wZuck/YAKB/firmware/README.zh-CN.md

# YAKB ZMK 固件

本固件同时用于 A0 与 B1.1：GPIO 和矩阵未变，`yakb-a0` 文件名保留 shield / 构建标识。B1.1 只在独立载板装一个 nice!nano，主板 U1 禁装主控；新增模拟滤波后重新校准。

[English](README.md) · [完整复现记录](../docs/reproduce.zh-CN.md)

主控固定为 **nice!nano v2 / nRF52840**。`prebuilt/yakb-a0.uf2` 为键盘版，`prebuilt/yakb-a0-calibrator.uf2` 为 USB CDC 校准版；SHA256 见 `prebuilt/SHA256SUMS`。两者均已编译，尚未上板测试。

使用 `config/west.yml` 固定顶层版本，`west-lock.yml` 冻结全部实际依赖。普通版与校准版共享相同的配列、主控映射、5 行/15 列扫描和 60 个有效位置。矩阵空位 mask 为 `0x0 0x2 0x4002 0x1001 0x6b73`。

## 烧录与校准

1. 断开电池，以 USB 数据线直接连接主控。按 nice!nano 文档进入 UF2 bootloader，复制校准版 UF2。
2. 确认 3.3V、Q1 门极时序和 U4 输出没有异常，再连接出现的 USB CDC 串口；选择常规 115200、8N1。CDC 是 USB 虚拟串口，速率并不决定 EC 扫描速度。
3. 输入 `ec` 并用 Tab 查看设备名，本版节点名为 `kscan0`。若固件输出不同，以自动补全结果为准。
4. 60 键正式机构装好后运行 `ec kscan0 calibration start`。低值采样时不按任何键；提示高值采样后按驱动提示逐个慢按、出现星号后释放，直至完成。
5. 运行 `ec kscan0 calibration export`，保存串口输出作为首件记录；运行 `ec kscan0 calibration save` 明确写入 Flash。
6. 断电重启，核对校准恢复；必要时运行 `ec kscan0 calibration load`。切回正常版 UF2 后再次检查所有键；不要擦除 settings 区来“更新固件”。

少量机构试装用于观察波形、噪声和趋势；完整校准流程需要所有有效位置，不能把未装键的读数当成成品结果。不要在校准过程中让电池或 USB 电源不稳定。

## 默认行为

Fn+1/2/3 选择蓝牙槽位；Fn+4 清除当前槽位配对；Fn+H/J/K/L 为方向键；Fn+Esc 进入 bootloader。默认通过 ZMK 的 USB/BLE 行为工作，细节见 `yakb.keymap`。

D19=P0.02/AIN0 是感应 ADC；D18 不用于 ADC。`power-gpios` 为低有效，控制 Q1，只切断运放供电；MUX 和 nice!nano VCC 在轮询时保留。扫描间隔初始为 4/8/12 ms，需测量实际帧率、漏首击和功耗。深睡眠禁用，当前没有独立可靠唤醒电路。

文件级检查和编译成功不代表 EC 动态范围、RF、功耗或温升已验证。每次修改传感、前端增益或机构预压后重新校准。

## 本版修复与双模切换

编译前必须执行 `scripts/prepare_firmware.py` 应用[经哈希校验的驱动补丁](patches/README.zh-CN.md)。它修复空闲后首键、无效校准端点及零噪声校准的除零问题。合作式优先级参数为 15（实际 -1），开启内核断言。960 组首键逻辑回归及恒定 ADC 的实际校准函数测试通过；不等于上板时延测量。

USB HID 和 BLE HID 均启用。Fn+5 选择 USB，Fn+6 选择蓝牙；Fn+1/2/3 切换蓝牙槽位。首次默认优先 USB，手动选择会保存；同一时刻向所选端点发送按键，不是同时向两台设备广播。连接数据线可作为有线键盘使用，电池断开也可工作；选择 BLE 后可边充电边蓝牙使用，电池开关须打开才能充电。
