wZuck/YAKB/docs/case-design.zh-CN.md

# 外壳改版：降低前沿，收掉方盒感

> **版本范围：A0 基础设计 / 历史记录。** 当前整机为 B1.1；独立主控、直接 USB、专用底壳与 FPC 以 [B1.1 说明](modular/README.zh-CN.md) 和[文件版本表](file-map.zh-CN.md)为准。主板 U1 不装主控。

[English](case-design.md) · [兼容性](compatibility.zh-CN.md)

第一版采用 25.1 mm 等高平底壳，容积和净空简单，但侧面过直、前沿偏厚。当前主方案已改为 **R8 大圆角、下裙内收、浅楔形底面**。这是实际 CAD 修改，不只是换渲染颜色。

新版外壳与键帽包络

| 项目 | 第一版 | 当前版 |
| --- | --- | --- |
| 平面外包络 | 301×110.6 mm | 299×108.6 mm |
| 标称壳体前高，不含脚垫/键帽 | 25.1 mm | 21.4 mm，减少 3.7 mm / 约 15% |
| 标称后高 | 25.1 mm | 25.1 mm |
| 底面 | 平底 | 约 1.95°，贴桌后形成低倾角 |
| 顶部平面圆角 | R5 | R8 |
| 侧面 | 等宽直墙 | 下裙约内收 1.0 mm，多段斜面过渡 |
| 上框边缘 | 直角 | 0.7 mm 圆边 |
| 电池 | 水平、深腔 | 与内底面平行，重新检查包络 |
| 定位板外缘 | 裸露层间空隙 | 0.3 mm 边缘间隙的台阶口袋，上缘封住空隙 |

CAD 侧面

尺寸均以 PCB 顶面 z=0 定义；本页包络与旧报告数值沿用构造坐标，交付 CAD 的 Y 为其负值。前/后高是壳体顶面到延伸底面平面的标称高度；实际圆角和下裙会收去下缘材料。底板厚度 2.4 mm，前端底面 z=-10.8，后端 z=-14.5。主控仍在前右下方，因此保留约 0.5 mm 级别的模型净空；继续削薄需改变主控安装、插座高度或内部布局，不能只削外壁。

电池仍是完整包络 ≤60×35×5.5 mm 的带保护 1S 软包；它沿内底面倾斜，并不要求弯折电池。当前旋转后的轴向包络约 x=114…174、y=5.417…40.584、z=-11.144…-4.456。试装时使用与该厚度相符的固定材料，避免电芯或保护板受压。

## 实际参考了哪些开源壳

- [Bakeneko 60 V3](https://github.com/kkatano/bakeneko-60)：参考低前沿、明确侧面比例和倾角。上游标称前高 18.5 mm、6°、外包络 295×110×30 mm。它没有本项目的前部插座主控、电池和 NiZ 叠层约束，数值不能直接套用；本版也没有宣称采用其 O-ring 安装结构。
- [PH60](https://github.com/ph-design/PH60)：参考可打印外壳、独立电池空间、可拆装上盖思路；已查阅本地 HHKB 6u STEP。没有直接复制上游网格或磁吸结构。上游分体打印解决消费级打印床限制；本版当前仍为一体件，需要约 320 mm 级平台或服务。
- [HSKB](https://github.com/hungrygeek/HSKB) / 原始 Dev01-D 版本：参考真实 6u HHKB 底行与两侧挡块的比例；不能把 MX 一体定位板直接替代 NiZ 1.6 mm 定位板。
- [ECneko60](https://github.com/mattyintegrals/ecneko60)：真实 NiZ + EC60 + 开源 Bakeneko 的装配记录，用来核对“开源 60% 壳可作为 EC 改造基础”，同时确认需要修改机构，不能当作通用即插即用证明。

这些项目是结构和比例参考，当前壳体仍由 YAKB 参数化源独立生成。来源与许可边界见 [sources.md](sources.md)。

## 文件与打印

- `mechanical/case_base.step`、`case_bezel.step` 和 `assembly.step` 保留统一装配坐标。
- `mechanical/case_base.stl` 特意旋转到底面平放 z=0，适合切片；因此不要用这个打印 STL 与 PCB 坐标直接对齐。上框 STL 可由切片器平放。
- 先用同工艺测试圆角边缘、M2 热熔螺母、NiZ 和稳定器试片，再打印整套。
- 所选电池、主控、USB 插头与壳体的交集和最小间距见 `reports/mechanical.json`；真实线缆、螺丝和轴体仍须首件验证。

隐藏螺丝更新：上框正面完全封闭，8 颗螺丝由底面锁入上框盲孔螺母柱。新增定位板螺母柱避让与天线开窗；沉孔所需壁厚将下裙内收限制为 1.0 mm。实际 16 组装配交集见机械报告，螺丝长度和热熔螺母见[焊接指南](soldering-guide.zh-CN.md)。
