wZuck/YAKB/reports/drill-report.txt

Drill report for YAKB.kicad_pcb
Created on 2026-10-22T16:17:43

Copper Layer Stackup:
    =============================================================
    L1 :  F.Cu                      front
    L2 :  In1.Cu                    in1
    L3 :  In2.Cu                    in2
    L4 :  B.Cu                      back

Drill file 'YAKB-PTH.drl' contains
    plated through holes:
    =============================================================
    T1  0.250mm  0.0098"  (2 holes))
    T2  0.300mm  0.0118"  (243 holes))
    T3  0.750mm  0.0295"  (2 holes))
    T4  1.000mm  0.0394"  (4 holes))
    T5  1.092mm  0.0430"  (24 holes))

    Total plated holes count 275

Drill file 'YAKB-NPTH.drl' contains
    unplated through holes:
    =============================================================
    T1  2.499mm  0.0984"  (2 holes)  (with 2 slots)
    T2  2.499mm  0.0984"  (1 hole)

    Total unplated holes count 3
