wZuck/YAKB/docs/compatibility.zh-CN.md

# YAKB A0 兼容性与采购边界

> **B1.1 更新：** 以下内容描述 A0 基础板。独立主控、直接 USB、新底壳、FPC 和焊接差异以 [B1 说明](modular/README.zh-CN.md) 为准；B1 主板 U1 不再安装主控。

[English](compatibility.md) · [设计尺寸](design.zh-CN.md) · [装配指南](soldering-guide.zh-CN.md)

以 **GH60 / Poker 托盘外形和 Lot60 实际孔槽坐标**为默认接口，另提供完整自有打印壳。尚未指定或试装任何商用外壳，以下“目标”不代表已经实物兼容。

| 对象 | 结论与条件 |
| --- | --- |
| 自有 YAKB 底壳 + 上框 + plate_case | 共同参数生成，包络检查通过；NiZ 卡扣、胶碗预压、卫星轴和线材须首件验证 |
| GH60 / Poker 类托盘壳 | PCB 外形 285×94.6、安装孔槽参考 Lot60；逐个核对支柱、螺丝头、底部元件、电池净高和 USB，不能只看“60%” |
| Tofu 类金属壳及其他铝壳 | 未验证具体代际；须有天线非金属窗口、合适安装方式、电池空间。全封闭金属腔不作为默认 BLE 方案 |
| PH60 HHKB 6u 打印壳 | 可改造候选；上游定位板约 284.75×107.25×5 mm，与本版 1.6 mm NiZ 板不同，不能直接套用 |
| MX 60% 原配定位板 | 不直接适用；HHKB 底行、6u 空格和 NiZ 卡扣均需专用开孔 |
| 原装 HHKB/Topre 键帽 | 本版选 MX 十字 NiZ 滑块，不承诺兼容 Topre 键帽 |
| 普通 6.25u / 偏心轴 6u 空格 | 不适用；需要中心十字 6u，稳定器中心距 95.25 mm |
| NiZ 整张 60% 胶碗 | 必须逐键对照；优先分体碗或适配此 HHKB 布局的胶碗片 |
| 普通机械轴 ZMK 扫描固件 | 不适用；必须使用本项目 EC 驱动配置和逐键校准 |

## 统一坐标和安装接口

PCB 后左框角为 (0,0)，x 向右、y 向使用者；PCB 顶面 z=0。所有数值单位 mm。孔槽中心由 Lot60 板边基准平移得到，而非重新假定为整数网格。

| 孔槽 | X | Y | 外包络宽×高 |
| --- | ---: | ---: | --- |
| 左开口槽 | 1.4579 | 56.5010 | 7.00024×2.49936 |
| 左上圆孔 | 25.1983 | 27.9006 | Ø2.4994 |
| 中央长孔 | 128.1990 | 46.9998 | 5.00126×2.49936 |
| 左下矩形避让 | 93.0991 | 82.5500 | 7.6×15.1 |
| 下方长孔 | 190.4984 | 85.2005 | 5.00126×2.49936 |
| 右开口槽 | 283.5402 | 56.5010 | 7.00024×2.49936 |

槽只是 PCB 的避让轮廓。轴壳、胶碗、垫片和螺丝头的外径可能比槽宽大，仍须从实物或供应商模型检查。特别注意中央槽附近以及长键下方，禁止靠拧弯 PCB 强行装配。

## 外壳验配顺序

1. 导入 `pcb_envelope.step` 与目标壳体，统一坐标，检查全部支柱和孔槽；用 1:1 纸样复核。
2. 叠加轴壳、胶碗和定位板实际尺寸，确认 6 mm 初始板间净距能形成正确预压；螺丝头不能挤占机构。
3. 核对 PCB 下方最低主控约 z=-8.1，以及电池包络 z=-11.144…-4.456。电池完整包络包含保护板、包膜和导线。
4. 检查 USB 数据延长组件在后左 x=18.6465、z=-5 的开口；主控 USB 朝左，需要真实插头和弯线空间。
5. 为定位板设计可靠承托。`plate_tray.dxf` 只有托盘外形和键孔，未为所有第三方壳定义固定结构。
6. 检查天线区域 x=268…285、y=79…91 的金属避让，以及紧邻壳壁时的蓝牙表现。
7. 安装前确认开关、电池和复位线可达；不压电池、走线不跨热熔铜螺母。

## 自有壳加工

一体底壳尺寸 299×108.6 mm，适合 320 mm 级平台或打印服务；不能默认放入 256 mm 打印平台。优先 PETG/ABS/ASA，结合机器实际收缩率校准，先打印开孔和热熔螺母试片。保留原始 STEP，若分段打印，接缝、定位销及强度需要另外设计，现有 STL 未声明支持任意切片拼接。

自有壳定位板 295×104.6×1.6 mm，8 处边缘缺口避让上框螺母柱，右下有天线窗。上框改为底部锁入盲孔螺母，正面无孔；M2×20/18/16 分别用于后排/两侧/前排。孔径、螺母和螺钉头要求见[焊接指南](soldering-guide.zh-CN.md)。PCB支柱仍用Ø3.3×4.5 mm螺母孔。
