wZuck/YAKB/docs/consistency-review.zh-CN.md

# 全仓库一致性复核

[English](consistency-review.md) · [文件版本表](file-map.zh-CN.md) · [机器检查记录](../reports/repository-consistency.json)

复核日期：2026-10-23。当前整机为 B1.1；共享 A0 主板、定位板和上框。本次没有改铜、引脚或外壳几何，重点修正同一仓库内不同版本、操作说明、计算和交付表之间的矛盾。

| 发现 | 修正 |
| --- | --- |
| 根 README 推荐 B1.1，却仍把 A0 的 299×108.6 mm 壳体、40 个板位和 A0 下载入口当主体 | 中英文首页统一为 B1.1：299×136.6 mm 最大包络、46 个实装板位 / 接线位置加一条 FPC，使用配套底壳 / 舱盖入口 |
| 多份旧文档缺少范围提示，USB 延长与直接 USB 两种结构并列出现 | 为 A0 记录加版本范围；新增逐目录 / 文件版本表，明确共享件、当前件与历史件 |
| 设计说明称 CAD 不转换 Y，和已修正的交付文件相反 | 统一为 PCB / JSON 构造 y 向使用者，交付 CAD Y=-y；打印 STL 另有落床旋转 |
| 外壳前高同时为 21.0 和 21.4 mm，电池净距仍写 0.75 mm | 按参数和报告统一主体前高 21.4 mm、后高 25.1 mm，电池至底壳最小净距约 0.526 mm |
| “扫描总电流”又额外叠加一次背景电流 | 改为扫描 / 等待分别加权；同步基础与模块功耗报告、设计说明及多电池表。基础 1000mAh 混合情景约 12.8 天；B1 连续活动约 202–203 小时，均未实测 |
| B1 继承 A0 表，主板 U1 禁装项仍属实装，FPC 漏列 | U1 为独立 DNP，增加 FPC 线缆项；合并电子 BOM 与检查表同步，46 实装板位 + 1 FPC + 1 DNP + 60 电极，共 108 记录 |
| 小板插座坐标取焊盘平均值，封装统一写成泛称 | 改取保存 PCB 的原生封装原点、值与封装名；JMAIN 原点 (0,0)，引脚组中心 (20,9.5)，明确区分 |
| 基础 CSV 将所有非电极标成通孔；电池开关备注混入常开按钮 | 按实际贴片 / 通孔标面别，SW1 为保持式 SPST，SW2 为常开瞬时复位 |
| B1 共用图上仍印 A0 的 18 步编号；顶 / 底视图说明笼统 | 从同一原生主板数据另生成 B1 的 21 步编号图，小板顶视 / 主板镜像背视说明分开；线缆坐标显示“—” |
| 多电芯指南限制整个包为单电芯尺寸，并写成只允许 1S2P / 1S3P | 单芯仍可用带保护 1S；多芯分别核对各仓与共享保护板，仍只允许厂家配组单输出包 |
| 少量机构试装被写成可直接运行完整 60 键校准 | 少量试装先测波形；预编译完整校准须装齐 60 键，少键校准需要匹配测试固件 |
| 模块 ERC 检查只读顶层，漏看 `sheets[].violations` | 修正两处检查器；新增注入 ERC 子页、DRC、未连线与一致性错误的拒绝检查。当前保存及重新运行的原生报告均为零错误 |
| 小板逐焊盘 CSV 保留未布线时的空 NC 名称 | 从已保存 PCB 重新提取四张模块板的 CSV，并纳入输出哈希检查 |

检查包括：全部 Git 管理及本次新增交付文件的 SHA256 清单；JSON / CSV / Python 解析、ZIP CRC、PNG 解码、GLB / UF2 / STL / STEP / PDF 格式完整性、XML 与 DXF 解析；文档 / HTML 本地链接；逐项 BOM / 指南 / 原生封装坐标；FPC 24 路；主板及四张模块板原生 ERC/DRC；既有机械、渲染、加工 ZIP、固件哈希验证。机器报告逐文件列出实际执行的检查，不把格式检查写成全部工程性质证明。

复核命令：先用 KiCad Python 运行 `verify_modular.py` 刷新原生提取，再用项目 Python 运行 `verify_release.py`、`verify_modular_release.py`、`verify_repository.py --native`。内容修改后按[复现文档](reproduce.zh-CN.md)刷新对应产物，不能只重写哈希来消除过期提示。

未完成项仍是实物试验：NiZ / 稳定器配合、FPC 接触与锁止、USB 真实高度及插拔受力、扫描 / 充电噪声、蓝牙干扰、温升与续航。浏览器安全策略未允许本次打开本地指南页面，故未声称完成浏览器交互验收；已检查交付 HTML / JS、链接、数据和生成图片。
