wZuck/YAKB/docs/electrical-analysis.zh-CN.md

# YAKB 电气、干扰与功耗分析

> **B1.1 更新：** 以下内容描述 A0 基础板。独立主控、直接 USB、新底壳、FPC 和焊接差异以 [B1 说明](modular/README.zh-CN.md) 为准；B1 主板 U1 不再安装主控。

[English](electrical-analysis.md) · [计算数据](../reports/electrical-analysis.json) · [多电池研究](battery-options.zh-CN.md)

结论：支持 USB HID 和 BLE HID；已修复可确定的连接、封装和固件问题，但本版还没有实板噪声、射频或电流测量，不能把 ERC/DRC 通过当成抗干扰认证。下面明确区分原生文件测量、器件资料和计算假设。

## 双模连接

正常版与校准版实际构建均启用 `CONFIG_ZMK_USB=y`、`CONFIG_ZMK_BLE=y`。Fn+5 选择 USB，Fn+6 选择 BLE；Fn+1/2/3 选择蓝牙槽位。USB 初始优先，手动选择会保存；一次只向选中的端点发按键。接数据线可无电池使用，选择 BLE 后可以用 USB 供电并蓝牙输入。电池开关断开时不能充电。[ZMK 输出行为](https://zmk.dev/docs/keymaps/behaviors/outputs)

USB D+/D−留在成品主控与完整 USB 2.0 数据延长组件中，没有穿过主 PCB 的传感布线。线缆必须支持数据、保留屏蔽和可靠接头；不要改成仅充电线或自行拼裸线。nice!nano 原厂充电功能和电源路径见[官方文档](https://nicekeyboards.com/docs/nice-nano/)。

## 模拟信号与串扰

| 项目 | 本版证据 / 分析 | 处理与剩余验证 |
| --- | --- | --- |
| MUX 料号 | 原 `SN74HC4051D` 与引用的 TI 型号不对应；改成有效 SOIC-16 订货号 `CD74HC4051M96`，管脚和焊盘不变 | 采购 HC CMOS 版，不能随意换成 HCT 或 CD4051B；[TI 料号](https://www.ti.com/product/CD74HC4051/part-details/CD74HC4051M96)、[数据手册](https://www.ti.com/lit/ds/symlink/cd74hc4051.pdf) |
| 高阻 SENSE | 实际走线总长 **162.105 mm**；包括分支，不是端到端距离 | 这是当前主要模拟风险。寄生电容会压低信号，长线可能接收数字边沿与 RF；尚未做场求解或实板采样 |
| ADC / FB | ADC 总线长 **58.656 mm**，FB **21.034 mm**；ADC 被低阻运放驱动，FB 仍敏感 | 检查过冲、振铃、稳定性和射频整流；若不足，优先把两个 MUX、反馈和 C4 集中布置后重新布线，不能仅靠改软件阈值 |
| 放大与采样 | 非反相增益 101；SAADC 12 bit、内部0.6 V参考、1/6增益，名义量程3.6 V，1 LSB约0.879 mV，折算输入约8.70 µV | 这不是有效精度。3.3 V运放的输出摆幅、噪声与实际压下差值才决定裕量 |
| 放电与建立 | 每点10 µs放电、5 µs预采样，SAADC采集10 µs；每帧运放预热200 µs | R32×C4=1k×220pF，单独时间常数0.22 µs；总电容还包含两路MUX、走线与电极，不能用这个单值认证10 µs已足够 |
| 行列串扰 | 100Ω行串阻缓和边沿；仅选择一路MUX；未用通道接地；内层避让感应区 | 仍须测相邻键、多键和快速切换时的残留电荷；禁止随意给电极区加地平面或覆锡 |
| 电源 / 回流 | 各IC有去耦，Q1只切运放电源；MUX与VCC保留；没有连续地平面 | 地线总长约2458 mm是整网所有分支之和，不能当成单根回路线或阻抗。稀疏回流可能引入充电/数字地噪声，需示波器验证 |

OPA350 的 38 MHz 带宽不能保证这套长线布局稳定；数据手册给出的典型静态电流约5.2 mA、25°C最大7.5 mA。将它断电再开启也需要在实际负载下验证建立时间。[TI OPA350 数据手册](https://www.ti.com/lit/ds/symlink/opa350.pdf)

驱动读数期间有短临界区；它不等于已与 BLE 无线时隙协调。固件逻辑回归不模拟 SAADC 中断或无线抢占，应在持续蓝牙通信下测完整帧耗时、首键与释放事件。零噪声校准、无效端点和优先级问题已修复，见[修复记录](review-fixes.zh-CN.md)。

## 蓝牙与外部干扰

U1 天线朝PCB右侧，全铜层避让范围为 x=268…285、y=79…91 mm。原定位板在其正上方是实体，若用金属会构成潜在遮挡；现已在右 HHKB 挡块下开 **21×16 mm** 窗，实际 STEP 与该投影的交集为零。优先无铜 FR4/G10 定位板和塑料外壳；即使选金属板，也必须保留开窗。

开窗仅移除了直接上方金属，不能认证射频性能。金属壳、USB屏蔽线、电池铝塑膜、铜螺母和手部仍会改变天线环境；线缆不得穿过该区。多电芯版本将电芯放在后部，须重新测EC基线和蓝牙。不能将几何距离换算成保证的无线距离。

2.4 GHz Wi-Fi、USB3设备和拥挤无线环境可能造成丢包/重传；BLE重传又会提高电流。塑料壳也不能保证不受影响。用固定接收端对比裸板、闭壳、USB延长线安装、多电芯安装四种状态，在1/3/5 m和常用桌面位置记录RSSI、断连、按键丢失与释放；同时运行附近Wi-Fi流量。RSSI仅辅助定位，最终以输入可靠性为准。

## 可复算功耗预算

**这些是未测量的情景估算，不是上下限保证。** 每帧60个有效位置，单是预热和忙等待就有 `0.2 + 60×(0.010+0.005) = 1.1 ms`，采集窗口再加0.6 ms，还没有计入转换、GPIO、MUX、调度和无线争用。因此不能把4/8/12 ms等待值直接当整帧周期。

采用帧耗时2/3/6 ms、扫描时总电流8.2/8.7/13.5 mA、背景0.1/0.25/0.6 mA三个情景。扫描电流包括运放和主控；背景包含保留供电、蓝牙平均开销与板级消耗。主控实际电流随CPU/RF状态变化，器件峰值不能替代整机平均值。[Nordic 电流说明](https://docs.nordicsemi.com/r/bundle/ps_nrf52840/page/chapters/current_consumption/doc/frontpage.html)

以电池侧电流作一阶预算，暂按VCC输入/输出电流近似相等；实际稳压效率、温度和负载必须测。另计每帧100nF电容完全充电的保守开销：

扫描阶段总电流已包含背景负载；背景电流仅按等待时长加权，避免重复计入。

`Iavg = (Ibackground × twait + Iscan_total × tframe + 0.1µF × 3.3V)/(tframe+twait)`

| 状态 | 等待 | 情景电流范围 | 中间估计 | 1000mAh、80%可用的中间续航 |
| --- | --- | --- | --- | --- |
| 活动 | 4 ms | 2.85–8.37 mA | 3.92 mA | 204小时，约8.5天 |
| 空闲 | 8 ms | 1.75–6.15 mA | 2.58 mA | 310小时，约12.9天 |
| 长空闲 | 12 ms | 1.28–4.92 mA | 1.96 mA | 408小时，约17.0天 |

每天8小时活动、16小时长空闲，中间估计约 **12.8天/1000mAh**。500mAh约减半；2000/3000mAh在电流不变时约翻倍/三倍。当前无独立唤醒电路，深睡关闭，因此不承诺几个月待机。实际帧若超过6 ms或RF重试频繁，电流可能超出表中范围。

默认约100mA充电，1000/2000/3000mAh的理想恒流下限分别10/20/30小时，实际还有恒压尾段和使用负载。不要为缩短时间直接桥接BOOST；提高电流需核对电芯、保护板、线缆和主控温升。[nice!nano FAQ](https://nicekeyboards.com/docs/nice-nano/faq/)

## 首板验收记录

1. USB直连、USB延长、USB充电+BLE、纯电池BLE分别记录VCC/AFE电源纹波、SENSE/ADC波形及每键空载/按下统计；探头本身会增加电容。
2. 至少记录每键1000帧空载/按下分布；首件目标为两分布可清晰分离、相邻键切换无误触。可用“压下差值≥10×噪声峰峰值”作为初始工程门槛，并检查整个温度/电量范围；这不是器件保证。
3. 测第一帧上电建立、最远电极、连续多键、缓慢回弹、空闲首击和BLE重传负载。若出现振铃/电源耦合，先改布局、回流或采样时序再重校准。
4. 在电池端记录活动/空闲/长空闲/重连/关机平均电流及峰值，用实测值替换报告中的假设。记录满电充电与多电芯包的温升；开关断开还要计电芯保护板自耗。

EC 现在使用 SAADC 逻辑通道1，物理输入仍为 AIN0/P0.02；逻辑0保留给 ZMK 电池驱动的 VDDHDIV5。原先两者共用逻辑0会覆盖通道设置，已分离并增加两种初始化顺序的回归检查。
