wZuck/YAKB/docs/modular/interface-review.zh-CN.md

# B1.1 接口修正与小样验证

[English](interface-review.md) · [尺寸合同](../../design/fpc-interface.json) · [整机说明](README.zh-CN.md)

复核使用 Molex 编制的 `2005281000-SD` 修订 C，2019-08-14 发布，PDF 第 5 页料号表含 **2005280240**，第 6 页是端部配合尺寸。[厂家图镜像](https://www.micro-processor.com/parts-file/c2-2005280050.pdf)。来源地址、文件 SHA256 和页码已记录；原图不随仓库重新分发。这是可追溯的图纸依据，不能据此声称采购批次已验收。

| 项目 | B1 旧文件 | B1.1 当前文件 |
| --- | --- | --- |
| 端部外宽 | 24 mm | 25 mm，带定位耳 |
| 露铜指 | 0.6 × 4 mm，前缘退缩 | 0.7 × 3.5 mm，延伸到插入边缘 |
| 定位/锁止 | 无定位耳 | 两侧定位耳及圆角，细节见尺寸合同 |
| 覆盖膜 | 每根铜指独立小开窗 | 每端一片连续开窗 |
| 补强 | 仅文字假设，没有实体厚度 | 非接触面 5 mm 补强，CAD 端部总厚 0.30 mm |
| USB 插头包络 | 8 × 5.5 mm | 12 × 8 mm 设计验收包络；开口 14 × 10 mm |
| USB 壳孔 | 仅底壳切孔 | 底壳和盖板共同切孔，剩余盖板屋顶 1.85 mm |

厂家图同时给出了有耳和无耳端部。本次选用带耳形式；“原来没有耳”本身不构成不合规，旧版确定的尺寸错误是外宽和铜指几何。

原先的“DRC 0”只验证了旧文件的连接和规则，没有证明它符合连接器配合图。B1.1 仍检查所有铜线间距；只有插入边缘铜指采用明确的负板边间距规则来允许贴边，且每个端部 footprint 允许其内部覆盖膜开窗合并。这两项是端子结构要求，刚性板和其他铜线的规则保持有效。端部名义尺寸、两端 4 mm 插入基准、线序及连续窗口另作检查。

短 FPC 另附 [含端部补强的机械包络 STEP](../../mechanical/modular/fpc_mating_coupon_envelope.step)；同名 `-native.step` 是 KiCad 均匀板厚输出，不能用它判断补强厚度。程序另检查试件确实来自当前底壳、整条软板没有越出外壳包络，四个交付打印 STL 的最低点均落床，见[试件文件检查](../../reports/modular/sample-checks.json)。

## 先加工两种试件

1. [短 FPC 试片加工 ZIP](../../fabrication/modular/YAKB-FPC-coupon-B1.zip)：两个插入端相距 25 mm，端部与整条软板共用同一生成函数和尺寸合同。只用于台架配合/导通验证，不装入整机，不是可替代长软板的通用 FFC。向软板厂提交同包 `FLEX-STACKUP.json`；覆盖膜、补强、表面处理必须一起报价。
2. [后舱底壳试件 STL](../../mechanical/modular/rear_pod_fit_coupon.stl)：从当前整机底壳直接裁取，包含 USB 开口、载板支柱、承压座和卡唇。配合 [同一后舱盖 STL](../../mechanical/modular/pod_lid_B1.stl) 使用。它保留真实斜底，已放到打印床平面，前侧为裁切开口。

实际后舱试件

[下载双语实测记录表 CSV](qualification-checklist.csv)。所有条目保持“待测”，没有填写虚构的验收结果。

## 记录后再决定整机加工

| 核对项 | 图纸或设计基准 | 实测记录 |
| --- | --- | --- |
| 采购料号与批次 | Molex 200528-0240；不凭外形替代 | 待填 |
| 端部厚度 | 0.30 ± 0.05 mm，包含补强与胶层 | 待填 |
| 插入与锁止 | 4 mm 名义插深；两端闭合后不翘起、无异常阻力 | 待填 |
| 导通 | 断电测 A1→B24 至 A24→B1，并排除相邻短路 | 待填 |
| 主控安装高度 | 以实际焊接/插座组件测 PCB 顶面到 USB 口中心 | 待填 |
| USB 凹入与插头 | 测真实插口面相对壳外壁的位置、插头塑料尺寸及完全插入状态 | 待填 |
| 板边卡唇 | 1 mm 载板，0.30 mm 名义竖向间隙；不压元件 | 待填 |
| 受力 | 插拔时 PCB 不明显弯曲、不松动，端口焊点不承担壳体错位 | 待填 |
| ADC 与充电 | 纯 USB、纯电池、充电+BLE 三种状态记录噪声和电流 | 待填 |

USB 的 12 × 8 mm 数值是本设计要求使用的插头外壳包络，不是对所有 USB-C 线缆的尺寸承诺。nice!nano 官方给出的模块总厚度为 3.2 mm，但未把它当作“USB 口中心高度”；现有 6.5 mm 模块及安装包络也不是厂商精确模型。[nice!nano 官方规格](https://nicekeyboards.com/nice-nano/)

目前完成的是图纸与文件复核、原生电气规则和选定实体净空检查。表内实测项没有填写，不能将本次修订称作实物已通过。
