wZuck/YAKB/design/pin-map.csv

Signal | Pro_Micro_D | nRF52840_pin | U1_pad
ROW_DRV0 | 0 | P0.08 | 2
ROW_DRV1 | 1 | P0.06 | 1
ROW_DRV2 | 2 | P0.17 | 5
ROW_DRV3 | 3 | P0.20 | 6
ROW_DRV4 | 4 | P0.22 | 7
MUX_A | 5 | P0.24 | 8
MUX_B | 6 | P1.00 | 9
MUX_C | 7 | P0.11 | 10
MUX0_INH | 8 | P1.04 | 11
MUX1_INH | 9 | P1.06 | 12
DRAIN | 10 | P0.09 | 13
AFE_ON_N | 15 | P1.13 | 16
ADC | 19 | P0.02/AIN0 | 18
