wZuck/YAKB/assets/modular/B1-controller-plan.png

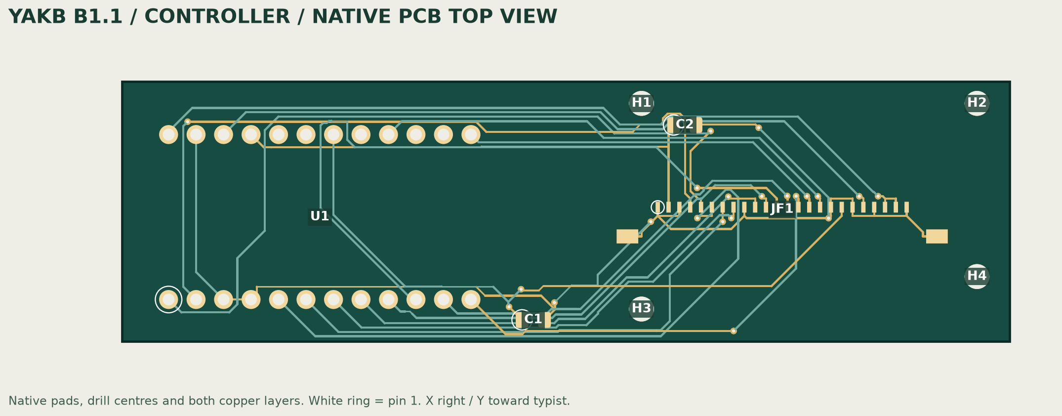
assets/modular/B1-controller-plan.png
