wZuck/YAKB/assets/modular/B1-FPC-coupon-plan.png

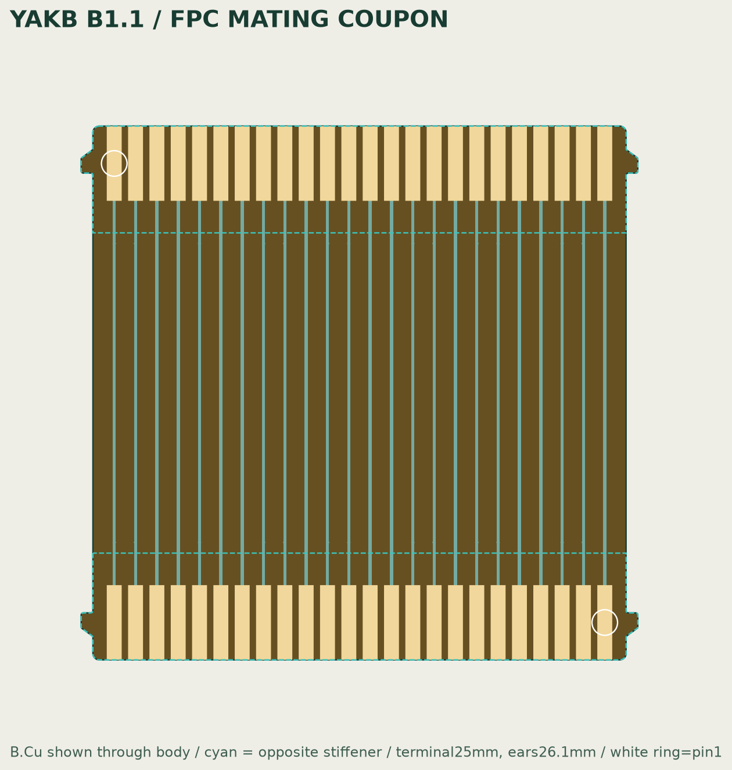
assets/modular/B1-FPC-coupon-plan.png
