wZuck/YAKB/assets/modular/B1-interposer-plan.png

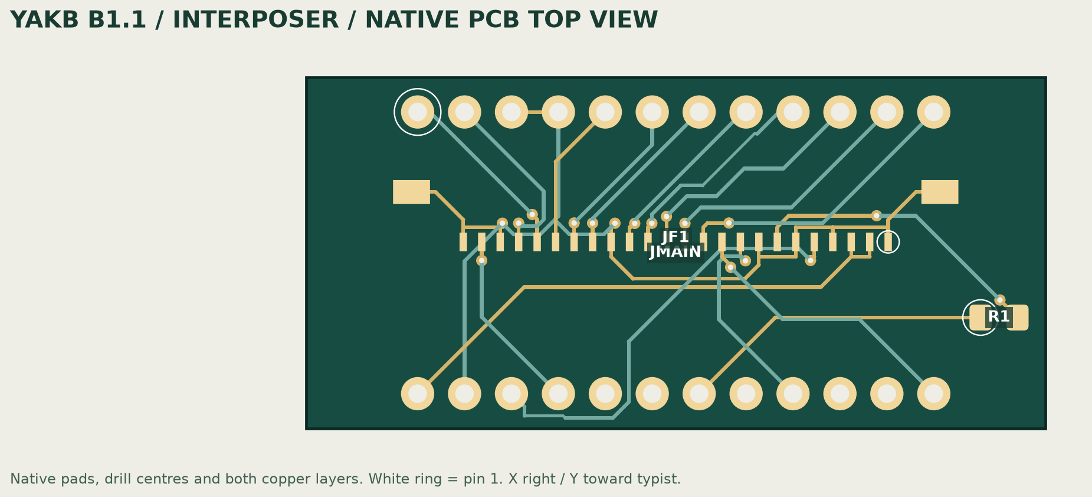
assets/modular/B1-interposer-plan.png
