wZuck/YAKB/assets/modular/B1-shaped-FPC-plan.png

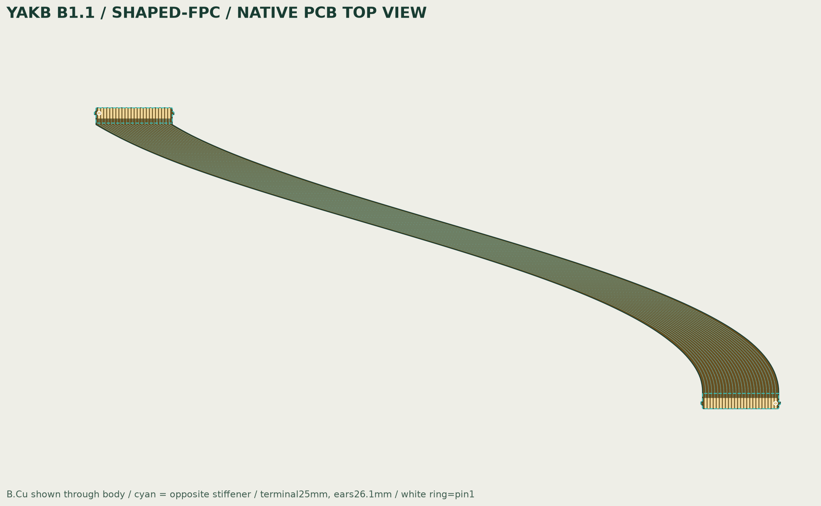
assets/modular/B1-shaped-FPC-plan.png
