wZuck/YAKB/assets/modular/B1-top.png

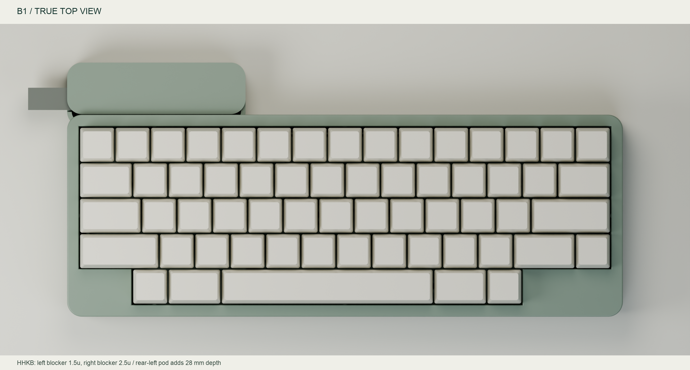
assets/modular/B1-top.png
