wZuck/YAKB/assets/pcb-bottom.png

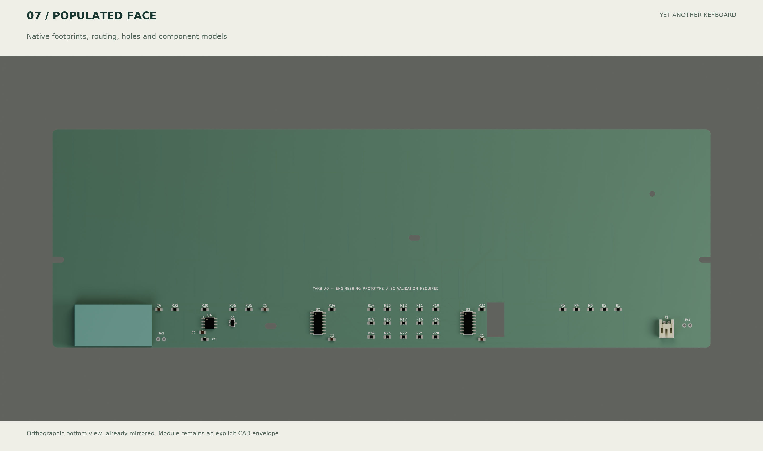
assets/pcb-bottom.png
