wZuck/YAKB/assets/pcb-top.png

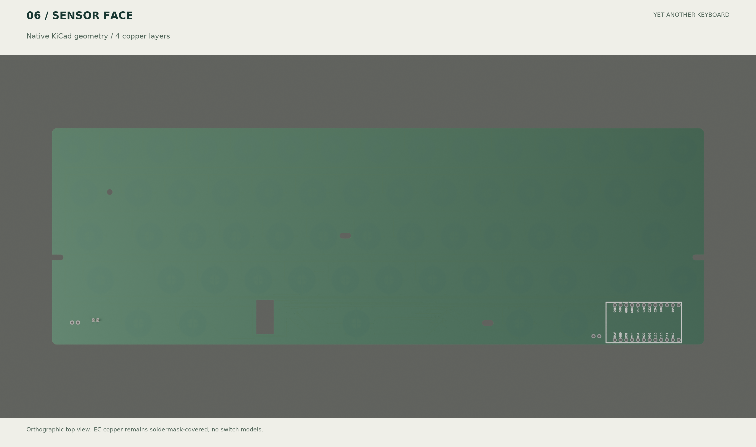
assets/pcb-top.png
