wZuck/YAKB/docs/inventory-review.zh-CN.md

# 库存对照与采购建议

> **版本范围：A0 基础设计 / 历史记录。** 当前整机为 B1.1；独立主控、直接 USB、专用底壳与 FPC 以 [B1.1 说明](modular/README.zh-CN.md) 和[文件版本表](file-map.zh-CN.md)为准。主板 U1 不装主控。

[English](inventory-review.md) · [正式 BOM](../hardware/BOM.csv) · [电气分析](electrical-analysis.zh-CN.md)

2026-10-23 按用户提供的元件库存工作簿“库存明细”表核对。表中数量源于订单汇总，不代表实物已盘点、未使用或完成型号验证。这里仅保留与 YAKB 有关的规格和判断；原始工作簿及订单数据不纳入仓库。

**决定：保留 nice!nano v2 架构，不进行 XIAO 迁移。PCB、0805 手焊封装和机械结构保持现状；补买缺少的少量元件比迁就库存改板更合适。** 修正 BOM 中 U2/U3 残留的旧料号为 `CD74HC4051M96`，与现有原理图、PCB 和电路源一致，并新增 BOM 一致性检查。

## 库存可用性

| 库存明细位置 | 物料 | 结论 |
|---|---|---|
| 第39行 | nice!nano 名称的 nRF52840 兼容板，1块 | U1 的候选；先核对每个 GPIO、BAT/3V3/RESET、USB方向、板厚、充电电流和天线位置。订单名称不能证明与原厂 v2 电源/布局一致，暂不认定为已验证直接替代 |
| 第30行 | PTS645SM43SMTR92LFS，5只 | 可作 SW2 外接常开复位按钮候选。它是6×6 mm贴片按钮，不是当前2.54 mm双孔的直接插装件；可用两根线或小转接板，先检查触点组、绝缘与安装空间 |
| 第26–28行 | MSK-12C02 / MSK12C01-07 标题的拨动开关，各4只 | 可作 SW1 线束开关候选；标题混列型号，须确认实物型号、触点、额定电流与安装尺寸，不能仅按柄长选定。当前不新增未经验证的贴片封装 |
| 第41–42行 | 两种四股线材，各0.5m | 可在确认线径、绝缘和应力释放后用于低速控制线；不把普通散线当USB数据延长线 |
| 第48、51、57行等 | 0402 的100nF、1kΩ、1µF | 数值有对应项，但封装不符。保留0805以便手焊，不以0402直接作为合格装配替代 |
| 第49行 | 0805 10µF/25V X5R，已收20只、在途40只 | 封装相近但不是当前100nF、1µF或220pF；不为消耗库存修改模拟电路或启动负载 |
| 第44–46行 | 15pF/20pF、0603 10Ω | 不替代220pF C0G或100Ω行串阻 |
| 第37行 | 301230、110mAh电芯，2块 | 不作为正式电池方案。保护、充电倍率和引线规格未明确，默认约100mA充电不能仅凭容量判定合适；按现有模型单片仅约1.4天，且这是未实测比例估算。不自行把两片并联 |
| 第17、19行 | 7U卫星轴套装、133键键帽套装 | 7U不能代替本设计中心轴6u/95.25mm稳定器要求；133键数量也不能证明包含合适6u空格。2u零件逐件检查，可用则保留 |
| 第21–25行 | M2×5/M3×8/M1.6×2螺丝、M2×6/18铜柱 | 不替代底部M2×16/18/20螺丝和M2热熔嵌件；18mm铜柱不是18mm螺丝。M2×5头径4mm也超过现有螺丝包络的3.8mm上限 |
| 第7、11、14–15、35–36行等 | TTP223、1N4148、RGB、OLED | 不加入本版。TTP223不是此NiZ EC前端的替代件；现有EC结构不需要逐键二极管，显示/灯效会增加功耗和焊接 |

复位按钮的 SPST-NO 和贴片安装性质可查 [C&K 官方规格](https://www.ckswitches.com/products/switches/product-details/Tactile/PTS645/PTS645SM43SMTR92LFS)。兼容主控核对基准为 [nice!nano 官方引脚/原理图](https://nicekeyboards.com/docs/nice-nano/pinout-schematic/)，不能把原厂参数当成库存兼容板的实测参数。

## 需要补齐的电子件

数量为一块完整PCB的装机量；建议多买少量备件。以下是当前已确定的电路，不把库存“候选”算作已确认可用。

| 器件 / 规格 | 位号 | 装机量 | 采购要点 |
|---|---|---:|---|
| CD74HC4051M96，SOIC-16 | U2/U3 | 2 | HC版，不换HCT/CD4051B |
| OPA350UA，SOIC-8 | U4 | 1 | 不因其他运放便宜而直接替代 |
| AO3401A，SOT-23 | Q1 | 1 | P沟道及引脚顺序一致 |
| 100Ω，0805 | R1–R5 | 5 | 建议1% |
| 100kΩ，0805 | R10–R24、R30、R33–R35 | 19 | 建议1% |
| 1kΩ，0805 | R31/R32/R36 | 3 | 建议1% |
| 100nF，0805 | C1/C2/C3 | 3 | X7R，额定电压≥10V |
| 220pF，0805 | C4 | 1 | C0G/NP0，不能用库存15/20pF拼凑 |
| 1µF，0805 | C5 | 1 | X5R/X7R，额定电压≥10V；核对有效容量 |
| JST S2B-PH-K 水平2P | J1 | 1 | 配套线端及极性核对 |

另需确认 U1 主控/低矮插座、两种控制开关的安装方式、USB数据延长组件、带保护1S电池包、NiZ完整机构、兼容6u空格及稳定器、定位板与外壳。底壳螺丝为后侧3颗M2×20、两侧2颗M2×18、前侧3颗M2×16，配8颗M2嵌件；具体头部与嵌件尺寸遵循[装配指南](soldering-guide.zh-CN.md)。

## 同次检查发现的固件问题

冻结 ZMK 的 `battery_nrf_vddh.c` 使用 SAADC **逻辑通道0**；原 EC 配置也使用逻辑通道0。后初始化的通道设置会覆盖前者，导致电池与EC输入/增益配置不能独立保持。

现将 EC 改为 **逻辑通道1，物理输入仍为 AIN0/P0.02**；电池保留逻辑0/VDDHDIV5。这不是把线接到AIN1，不改变PCB网络。测试使用实际电池初始化函数，在两种初始化顺序下验证独立配置，并用旧通道0分配复现冲突。正常版与校准版都重新构建，固件包装增加实际DTS检查。ADC硬件并发、无线负载与实际采样噪声仍属于首板测试范围。
