wZuck/YAKB/mechanical/assembly.step

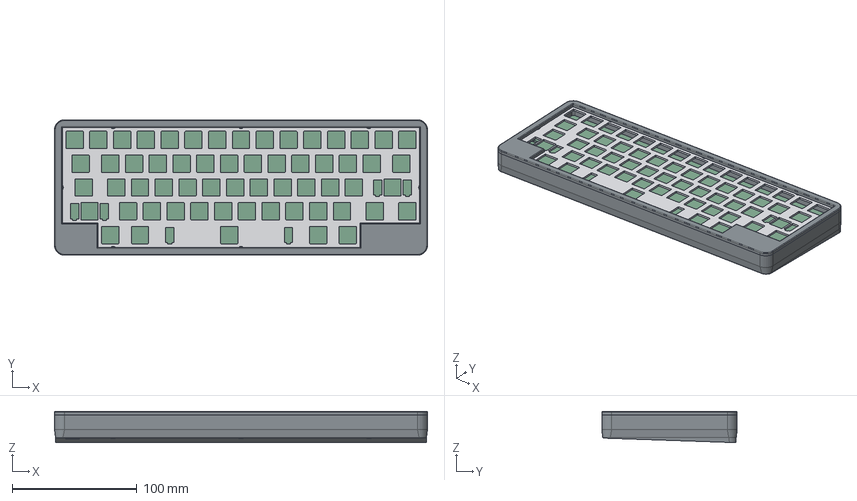
[picture p17: CAD file, 2026-10-22]
mechanical/assembly.step
299.0 x 108.6 x 25.1 mm
base
pcb
plate
bezel
battery_envelope
module_envelope
usb_plug_envelope
bottom_screw_envelopes
native_components
