wZuck/YAKB/mechanical/modular/assembly_B1.step

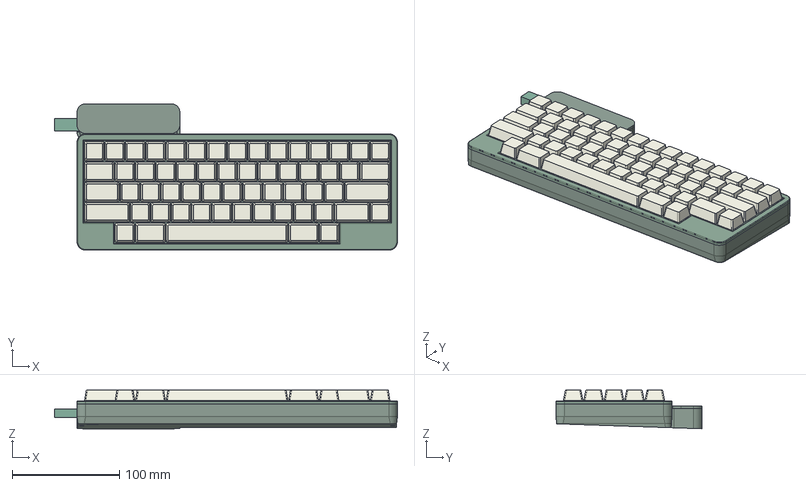
[picture p18: CAD file, 2026-10-23]
mechanical/modular/assembly_B1.step
320.0 x 136.6 x 36.0 mm
case_base_B1
pod_lid_B1
controller_module_envelope
external_usb_plug_envelope
shaped_fpc_envelope
pod_screw_envelopes
controller_populated
interposer_populated
pcb_envelope
components
plate_case
case_bezel
keycap_envelopes
battery_envelope
