wZuck/YAKB/mechanical/case_base.step

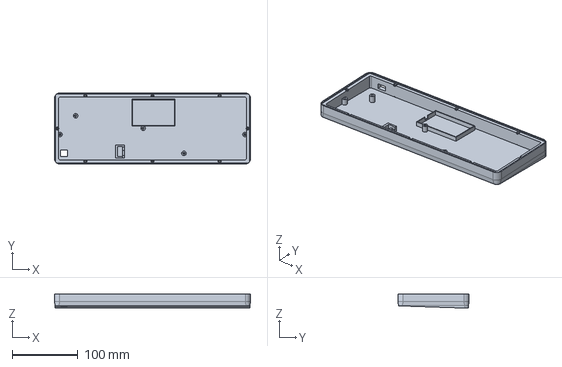
[picture p19: CAD file, 2026-10-22]
mechanical/case_base.step
299.0 x 108.6 x 22.1 mm
