wZuck/YAKB/mechanical/modular/fpc_mating_coupon_envelope.step

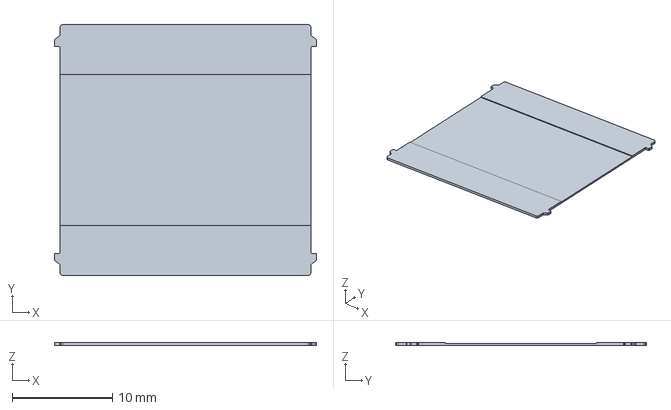
[picture p20: CAD file, 2026-10-23]
mechanical/modular/fpc_mating_coupon_envelope.step
26.1 x 25.0 x 0.3 mm
