wZuck/YAKB/mechanical/modular/YAKB-shaped-FPC-B1-native.step

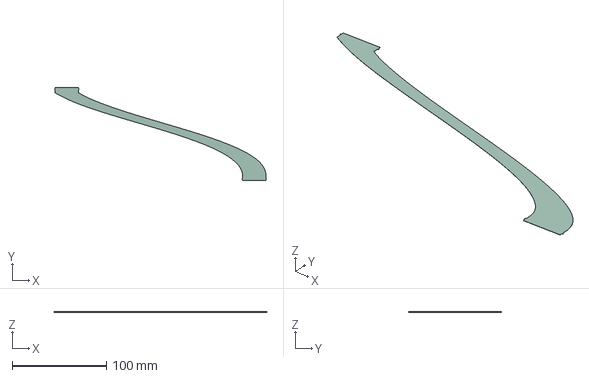
[picture p21: CAD file, 2026-10-23]
mechanical/modular/YAKB-shaped-FPC-B1-native.step
225.1 x 98.6 x 0.11 mm
