wZuck/YAKB/mechanical/modular/YAKB-FPC-coupon-B1-native.step

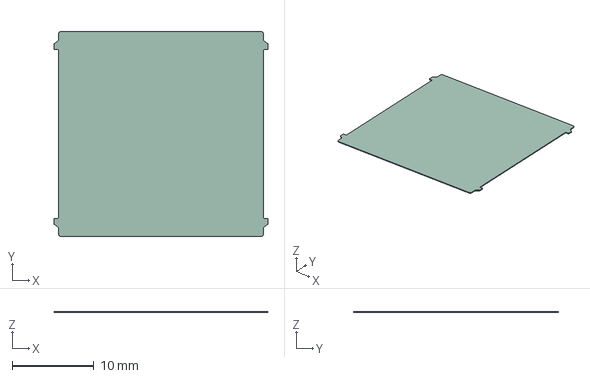
[picture p22: CAD file, 2026-10-23]
mechanical/modular/YAKB-FPC-coupon-B1-native.step
26.1 x 25.0 x 0.11 mm
