wZuck/YAKB/mechanical/niz_fit_coupon.step

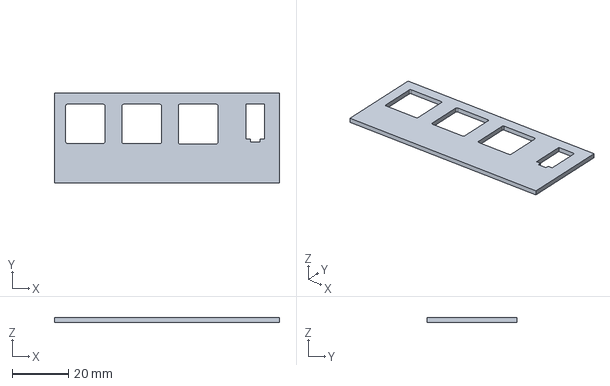
[picture p23: CAD file, 2026-10-22]
mechanical/niz_fit_coupon.step
80.0 x 32.0 x 1.60 mm
