wZuck/YAKB/mechanical/modular/controller_populated.step

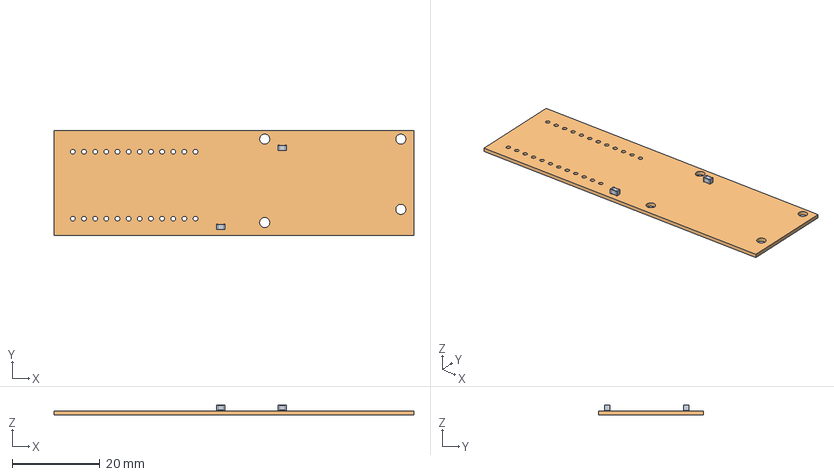
[picture p24: CAD file, 2026-10-23]
mechanical/modular/controller_populated.step
82.0 x 24.0 x 2.25 mm
