wZuck/YAKB/mechanical/pcb_envelope.step

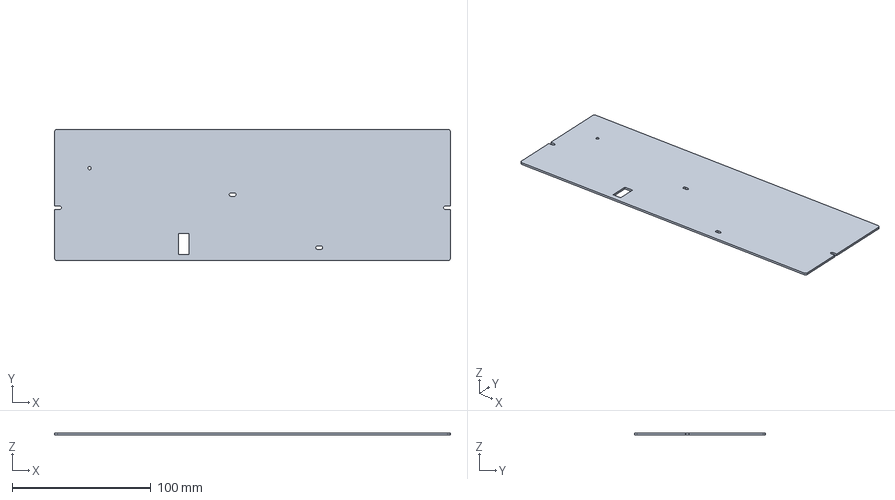
[picture p25: CAD file, 2026-10-22]
mechanical/pcb_envelope.step
285.0 x 94.6 x 1.60 mm
