wZuck/YAKB/mechanical/battery_envelope.step

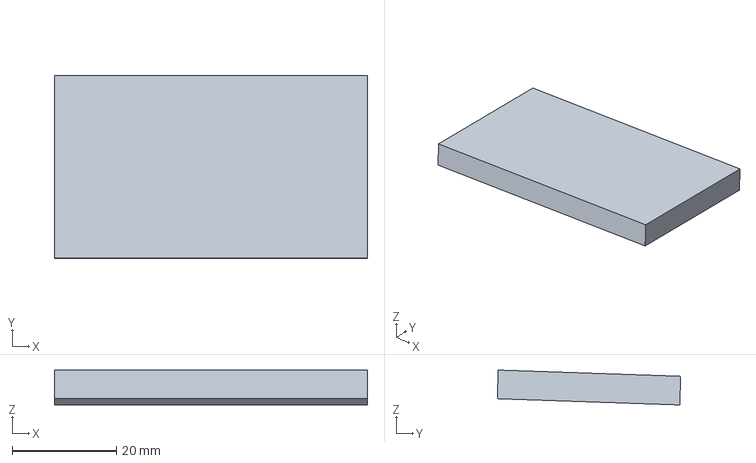
[picture p26: CAD file, 2026-10-22]
mechanical/battery_envelope.step
60.0 x 35.2 x 6.69 mm
