wZuck/YAKB/mechanical/modular/external_usb_plug_envelope.step

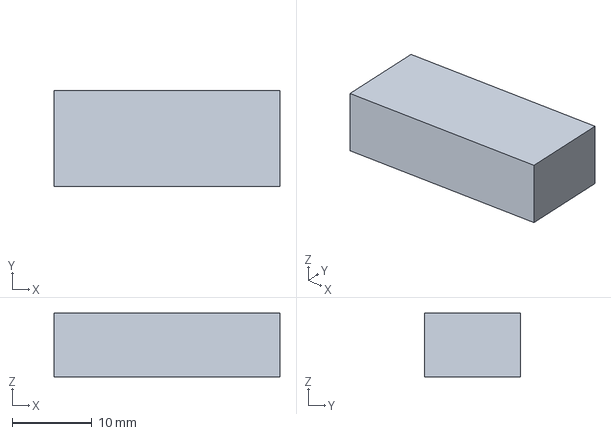
[picture p27: CAD file, 2026-10-23]
mechanical/modular/external_usb_plug_envelope.step
28.2 x 12.0 x 8.00 mm
