wZuck/YAKB/mechanical/components.step

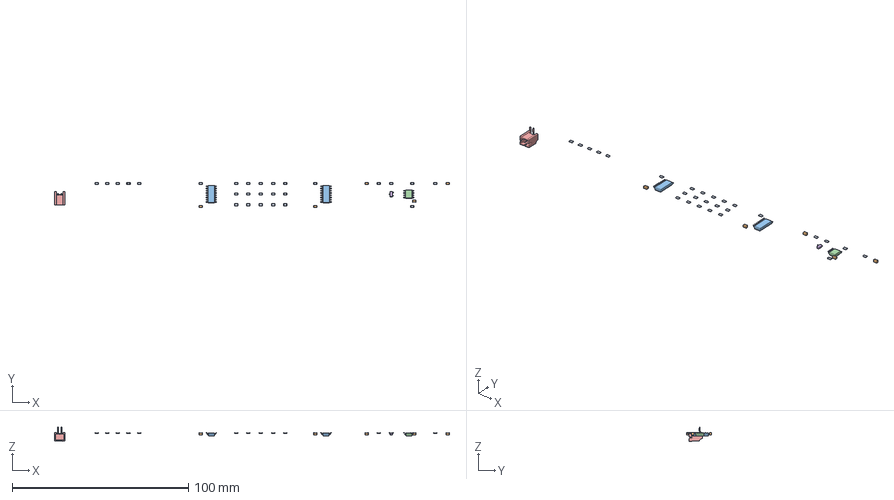
[picture p28: CAD file, 2026-10-22]
mechanical/components.step
223.9 x 14.2 x 8.25 mm
