wZuck/YAKB/mechanical/modular/controller_module_envelope.step

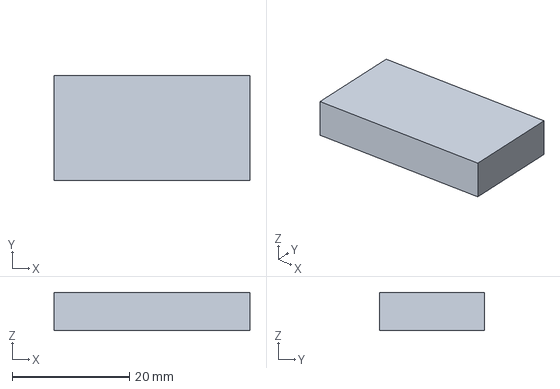
[picture p29: CAD file, 2026-10-23]
mechanical/modular/controller_module_envelope.step
33.5 x 18.0 x 6.50 mm
