wZuck/YAKB/mechanical/battery_pack_envelopes.step

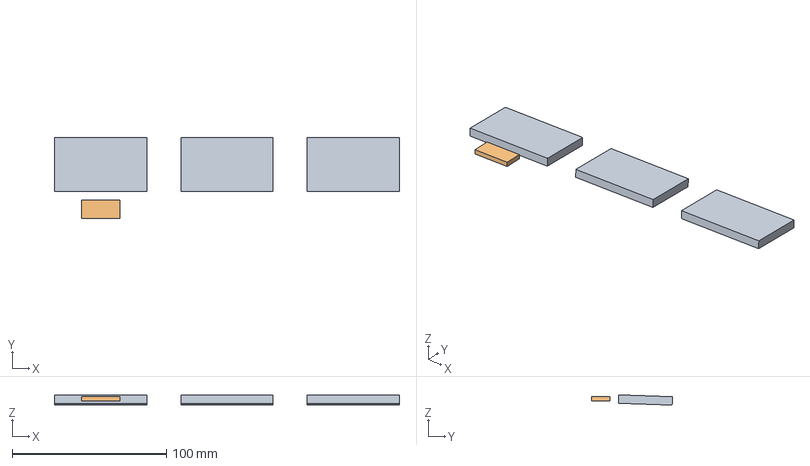
[picture p30: CAD file, 2026-10-22]
mechanical/battery_pack_envelopes.step
224.0 x 52.6 x 6.69 mm
