wZuck/YAKB/mechanical/modular/rear_pod_fit_coupon.step

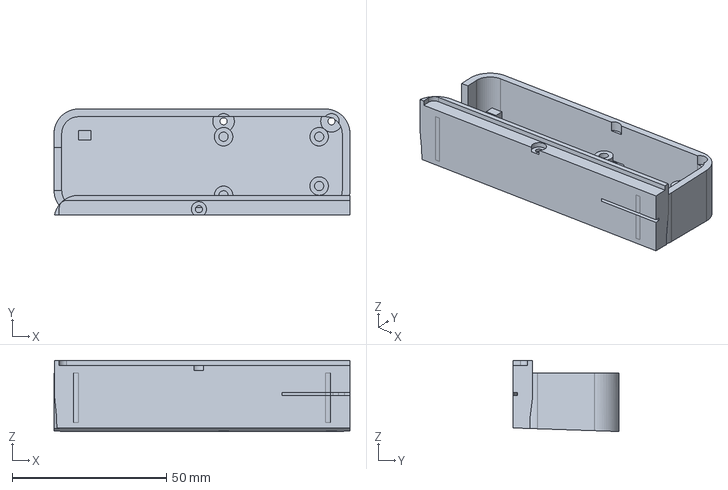
[picture p31: CAD file, 2026-10-23]
mechanical/modular/rear_pod_fit_coupon.step
96.0 x 34.4 x 23.1 mm
