wZuck/YAKB/mechanical/modular/shaped_fpc_envelope.step

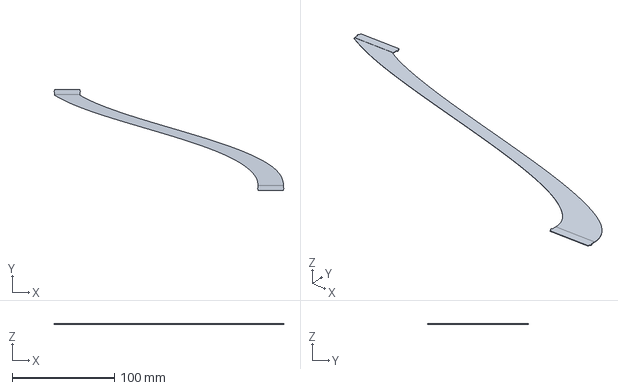
[picture p32: CAD file, 2026-10-23]
mechanical/modular/shaped_fpc_envelope.step
225.1 x 98.6 x 0.3 mm
