wZuck/YAKB/mechanical/plate_tray.step

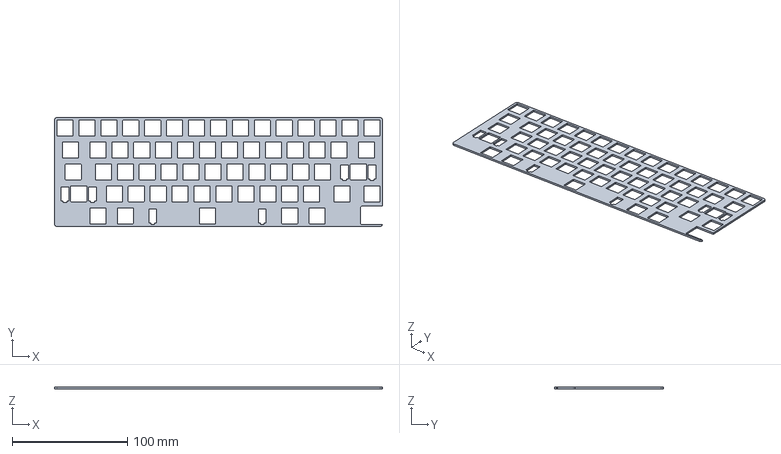
[picture p33: CAD file, 2026-10-22]
mechanical/plate_tray.step
285.0 x 94.6 x 1.60 mm
