wZuck/YAKB/mechanical/modular/YAKB-interposer-B1-native.step

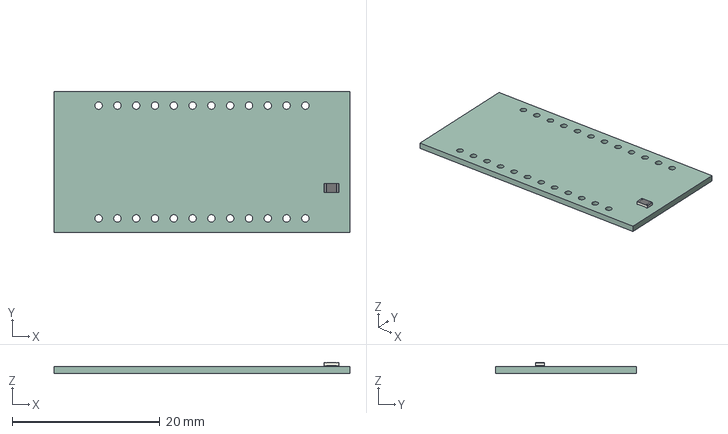
[picture p34: CAD file, 2026-10-23]
mechanical/modular/YAKB-interposer-B1-native.step
40.0 x 19.0 x 1.45 mm
R_0805_2012Metric
YAKB-interposer-B1_PCB
