wZuck/YAKB/mechanical/plate_case.step

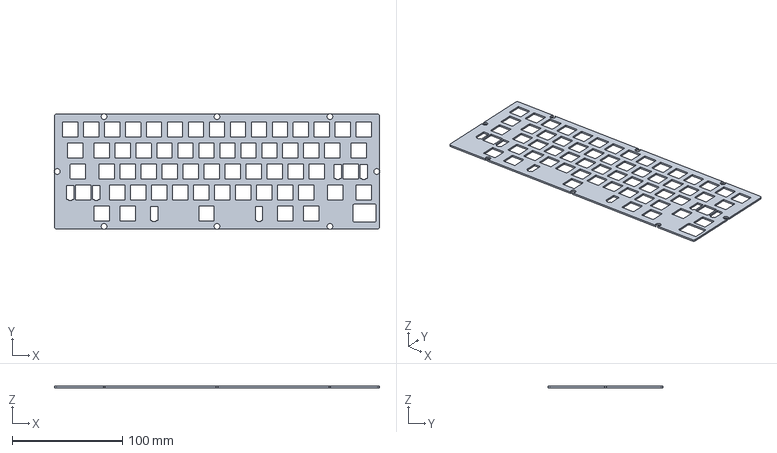
[picture p35: CAD file, 2026-10-22]
mechanical/plate_case.step
295.0 x 104.6 x 1.60 mm
