wZuck/YAKB/mechanical/case_bezel.step

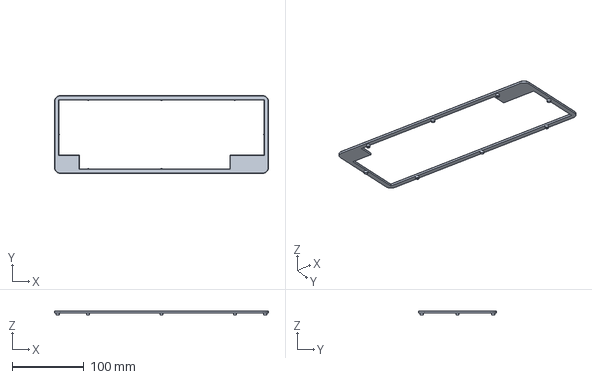
[picture p36: CAD file, 2026-10-22]
mechanical/case_bezel.step
299.0 x 108.6 x 6.00 mm
