wZuck/YAKB/mechanical/modular/case_base_B1_three_bay.step

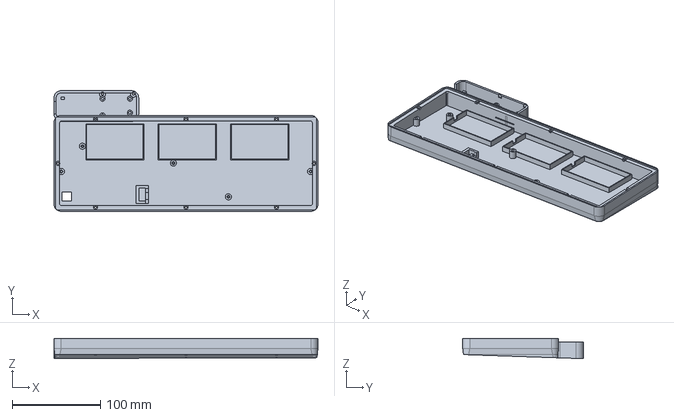
[picture p37: CAD file, 2026-10-23]
mechanical/modular/case_base_B1_three_bay.step
299.0 x 136.6 x 23.1 mm
