wZuck/YAKB/mechanical/keycap_envelopes.step

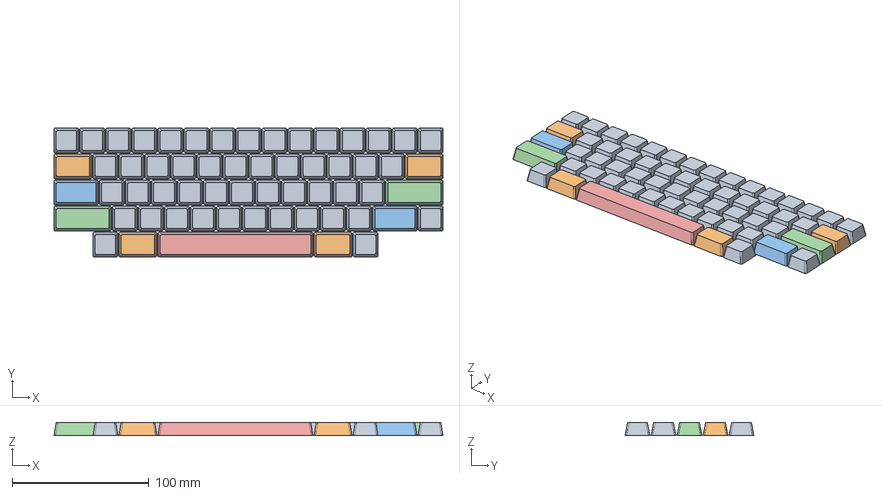
[picture p38: CAD file, 2026-10-22]
mechanical/keycap_envelopes.step
285.0 x 94.5 x 9.70 mm
