wZuck/YAKB/mechanical/modular/pod_lid_B1.step

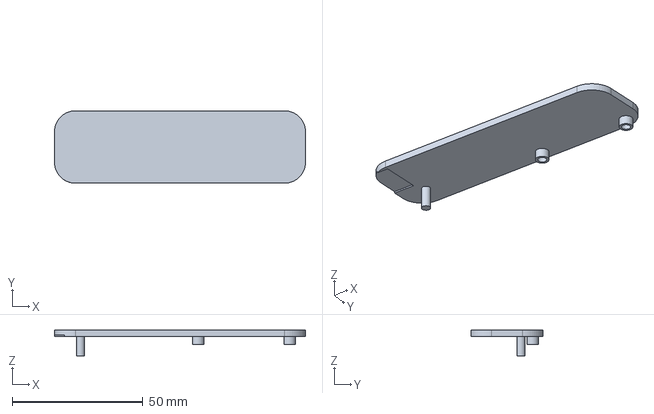
[picture p39: CAD file, 2026-10-23]
mechanical/modular/pod_lid_B1.step
96.0 x 27.7 x 9.80 mm
