wZuck/YAKB/mechanical/modular/case_base_B1.step

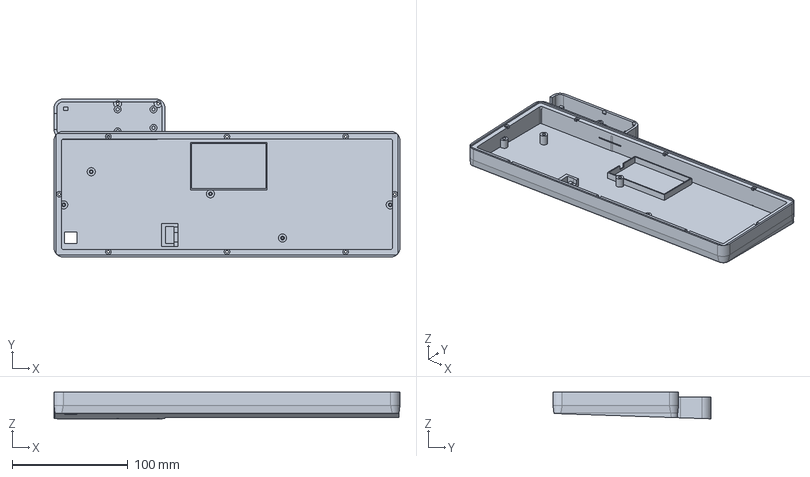
[picture p40: CAD file, 2026-10-23]
mechanical/modular/case_base_B1.step
299.0 x 136.6 x 23.1 mm
