wZuck/YAKB/mechanical/usb_plug_envelope.step

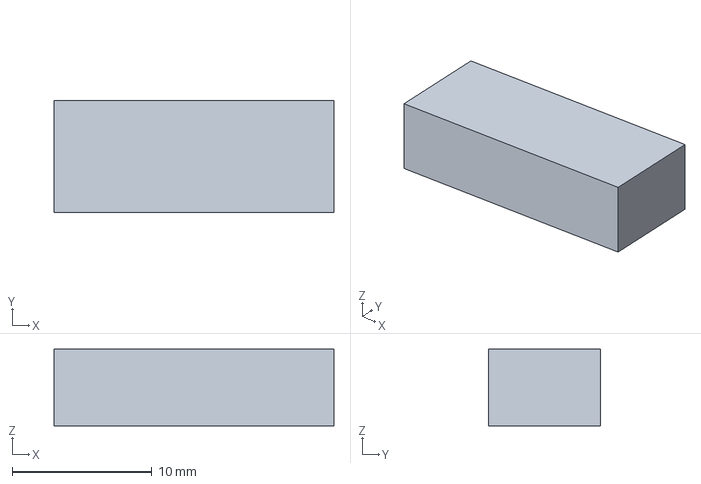
[picture p41: CAD file, 2026-10-22]
mechanical/usb_plug_envelope.step
20.0 x 8.00 x 5.50 mm
