wZuck/YAKB/mechanical/modular/interposer_pcb.step

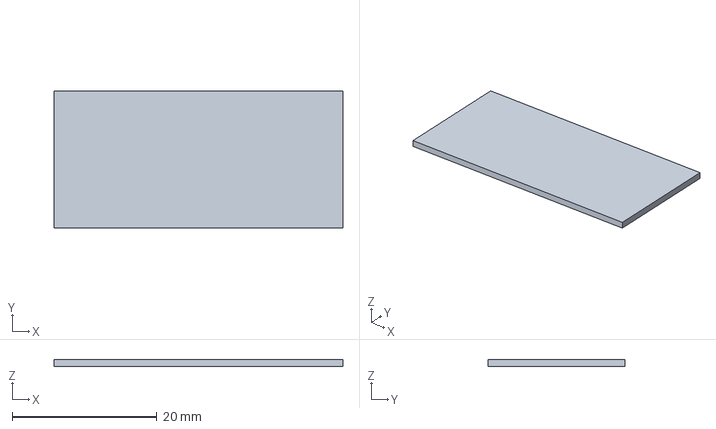
[picture p42: CAD file, 2026-10-23]
mechanical/modular/interposer_pcb.step
40.0 x 19.0 x 1.00 mm
