wZuck/YAKB/mechanical/modular/controller_pcb.step

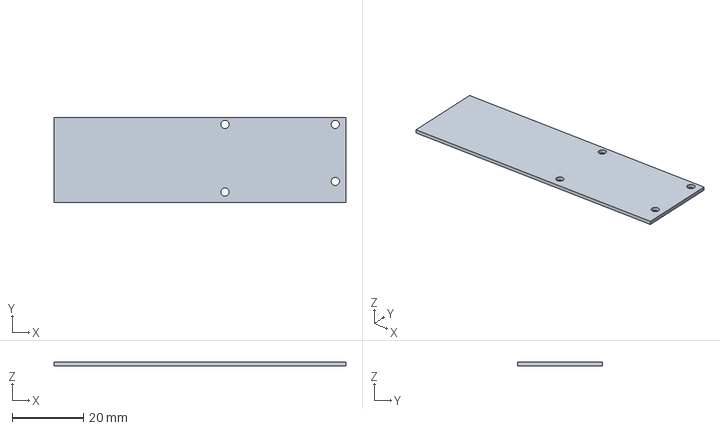
[picture p43: CAD file, 2026-10-23]
mechanical/modular/controller_pcb.step
82.0 x 24.0 x 1.00 mm
