wZuck/YAKB/(list of files, cad)

Other CAD files:
mechanical/case_base_three_bay.step
mechanical/modular/interposer_populated.step
mechanical/module_envelope.step
mechanical/modular/YAKB-controller-B1-native.step
mechanical/case_base.stl
mechanical/case_base_three_bay.stl
mechanical/case_bezel.stl
mechanical/case_screw_envelopes.step
mechanical/modular/case_base_B1.stl
mechanical/modular/case_base_B1_three_bay.stl
mechanical/modular/pod_lid_B1.stl
mechanical/modular/pod_screw_envelopes.step
mechanical/modular/rear_pod_fit_coupon.stl
mechanical/niz_fit_coupon.stl
mechanical/plate_case.dxf
mechanical/plate_tray.dxf
