wZuck/YAKB/hardware/soldering/index.html

跳到焊接步骤

YAKB手焊工作台Yet Another KeyBoard · A0

当前 B1.1 使用独立主控；原主板 U1 不装 nice!nano。 打开 B1 焊接工作台 → 本页保留 A0 参考顺序。

NiZ ELECTROCAPACITIVE 工程原型 A0

# 静电容， 照着图焊。

成品蓝牙主控、SOIC 模拟前端、0805 阻容。先完成低矮元件和断电检查，再插主控；USB 验证通过后才接电池。

固定 60 键 HHKB 6u · BLE / USB · nRF52840

40个实装板位 / 接线位置

18操作步骤

13元件组

60免焊感应单元

本页进度保存在当前浏览器。元件坐标与编号取自 KiCad；高亮图表示焊盘位置。尚未有实物焊接与续航验证。

00 / BEFORE THE IRON

## 先试片，再备料。

确认 NiZ 卡扣、板厚、胶碗、锥簧和卫星轴；6u 空格须为中心十字、95.25 mm 卫星轴间距。感应电极不要上锡，电池不要放在焊接台上。

下载 NiZ 试片 STL ↓

01 / SEQUENCE

## 焊接与装配顺序

操作完成度 0 / 18

重置进度

背面图已镜像为实际焊接视角；坐标仍为 PCB 基准坐标。白圈标记 1 脚，0805 的 1 脚标记不代表有极性。点击图片可放大。

02 / INVENTORY

## 逐位号检查表

40 个实装位置 + 60 个 PCB 感应单元；电极不需要焊接。

搜索工艺类型

位号 ↕ | 步骤 | 值 / 型号 | 封装 | 面别 | X mm | Y mm | 检查重点

没有匹配的位号，请调整筛选条件。

03 / POWER-ON

## 首次上电，分开验证。

这些是现有器件引脚，不是另设的测试点编号。

01

### 只有 USB

电池断开，先直连主控 USB，使用可限流的数据供电；从 100 mA 限流起步，异常就断开。正常后再接内部延长线。

先排除短路与极性错误

02

### 标称 3.3 V

U1-21 / U2-16 / U3-16 是 VCC；U1-23 / J1-2 是 GND。Q1-1 高时运放关闭、低时开启，U4-7 是脉冲供电。

脉冲电源需要示波器

03

### EC 与校准

U4-6 接 ADC，U1-18 为 D19 / P0.02 / AIN0。D18 不是本板的 ADC。MUX 两路 INH 不可同时低。

先小组试装，再校准 60 键

04

### 最后接电池

断开 USB，开关关闭，确认 J1-1 为正极后再插电池。默认约 100 mA 充电，BOOST 不桥接；开关关闭时不能给电池充电。

保护板不等于反接保护

04 / DESIGN FILES

原理图 ↗PCB ↗BOM ↓总装 STEP ↓外壳兼容性 ↗检查记录 ↗

文件检查不代表轴体、电池、充电温升、射频或续航已实测通过。图片中的主控、键帽及部分内部零件为包络示意，真实部件仍需试装。

YAKB — Yet Another KeyBoard2026-10-22 · A0 engineering prototype · 本地离线指南

关闭 ×
