wZuck/YAKB/assets/soldering-workbench.png

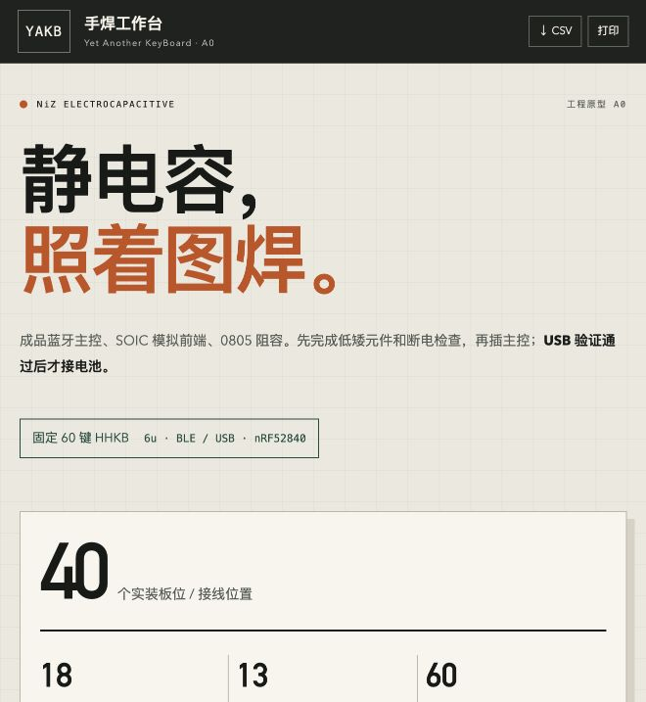
assets/soldering-workbench.png
