wZuck/YAKB/hardware/soldering/b1/step-01.png

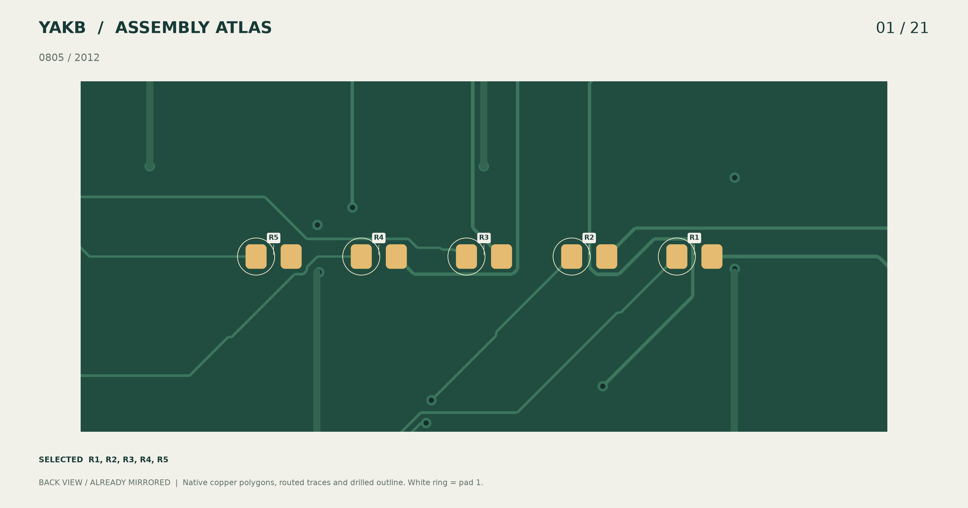
hardware/soldering/b1/step-01.png
