wZuck/YAKB/hardware/soldering/b1/step-02.png

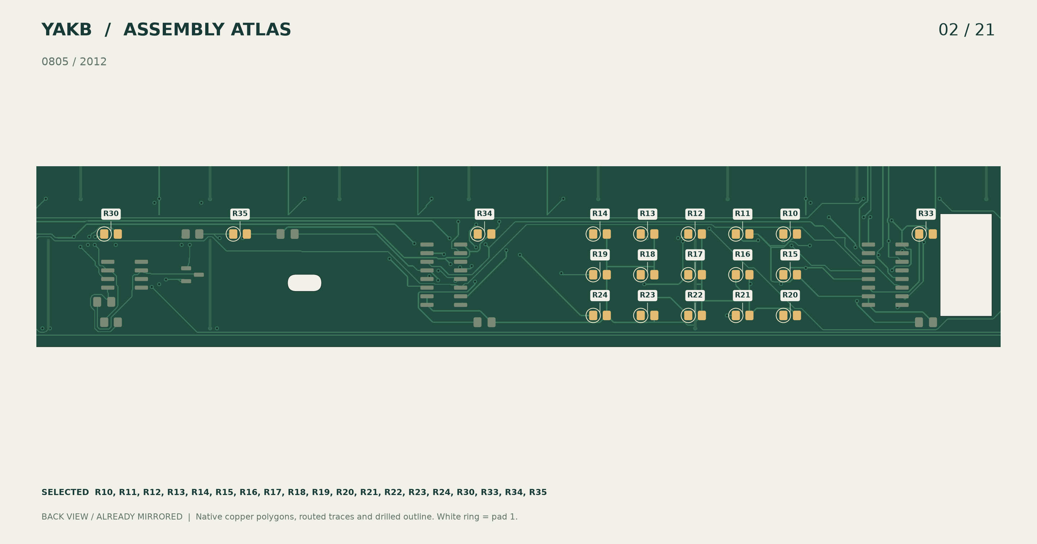
hardware/soldering/b1/step-02.png
