wZuck/YAKB/hardware/soldering/b1/step-03.png

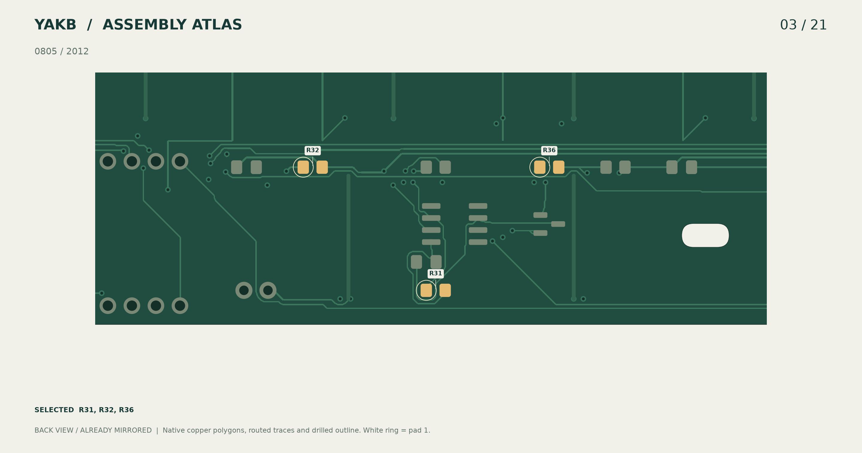
hardware/soldering/b1/step-03.png
