wZuck/YAKB/hardware/soldering/b1/step-04.png

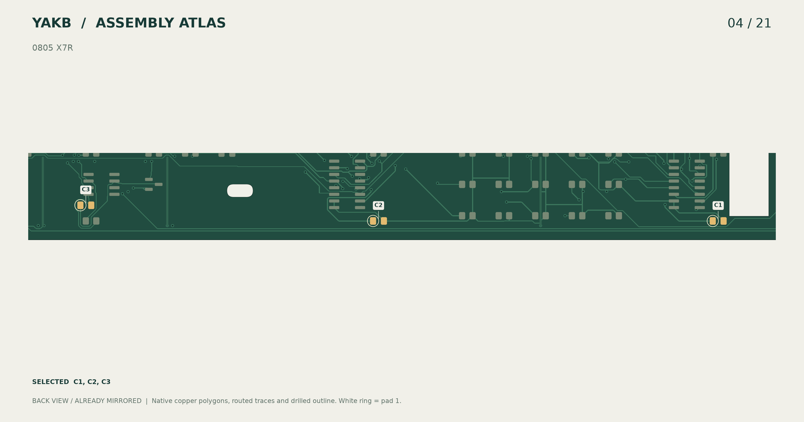
hardware/soldering/b1/step-04.png
