wZuck/YAKB/hardware/soldering/b1/step-05.png

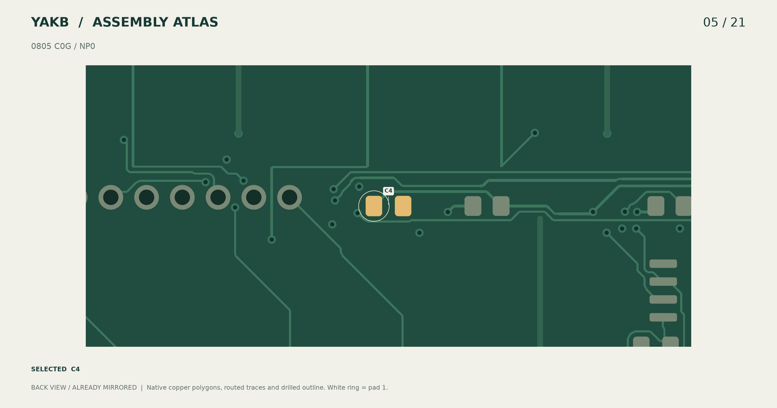
hardware/soldering/b1/step-05.png
