wZuck/YAKB/hardware/soldering/b1/step-06.png

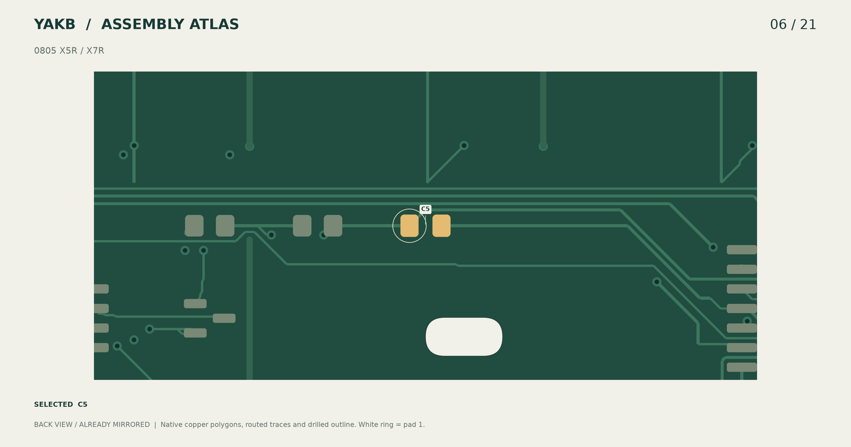
hardware/soldering/b1/step-06.png
