wZuck/YAKB/hardware/soldering/b1/step-07.png

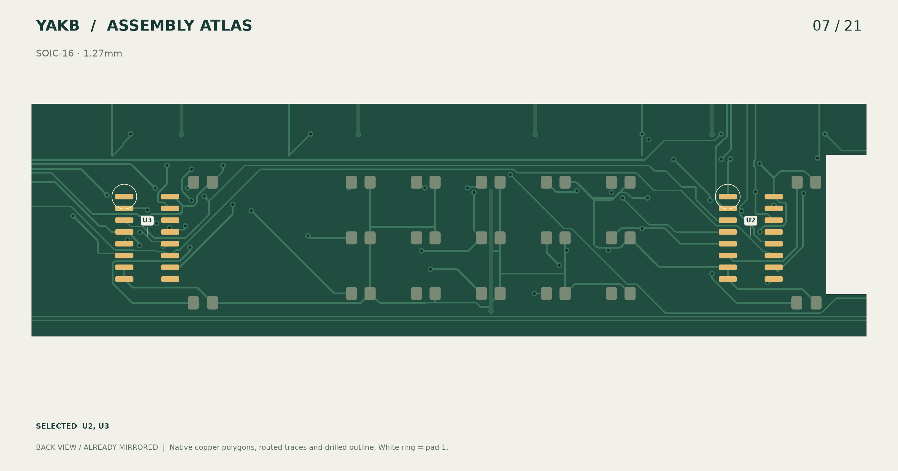
hardware/soldering/b1/step-07.png
