wZuck/YAKB/hardware/soldering/b1/step-08.png

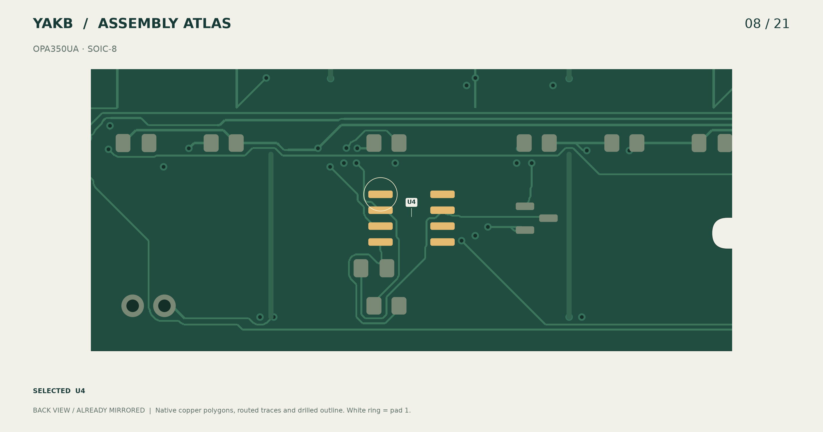
hardware/soldering/b1/step-08.png
