wZuck/YAKB/hardware/soldering/b1/step-09.png

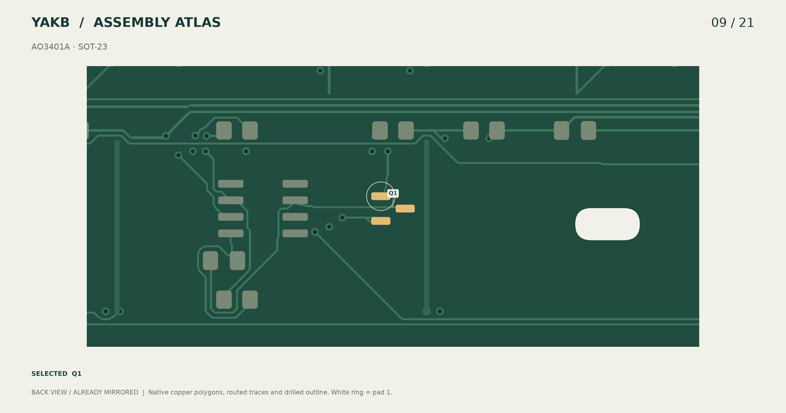
hardware/soldering/b1/step-09.png
