wZuck/YAKB/hardware/soldering/b1/step-10.png

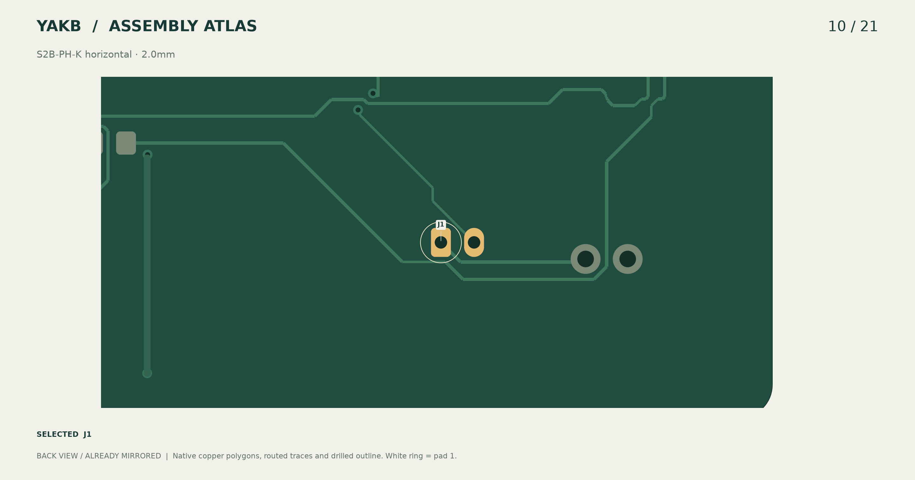
hardware/soldering/b1/step-10.png
