wZuck/YAKB/hardware/soldering/b1/step-11.png

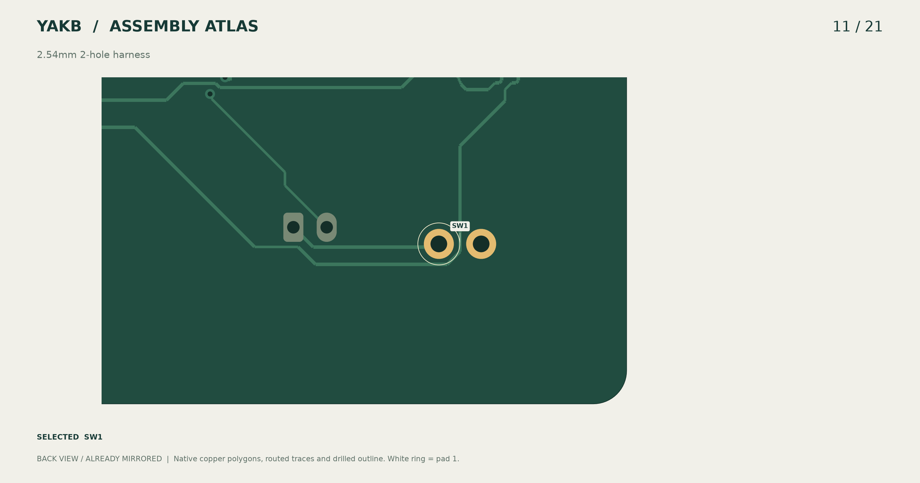
hardware/soldering/b1/step-11.png
