wZuck/YAKB/hardware/soldering/b1/step-12.png

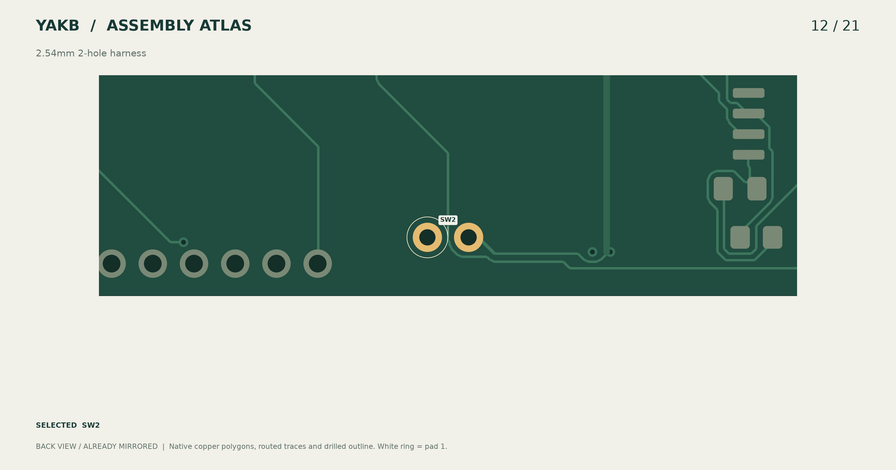
hardware/soldering/b1/step-12.png
