wZuck/YAKB/hardware/soldering/b1/step-17.png

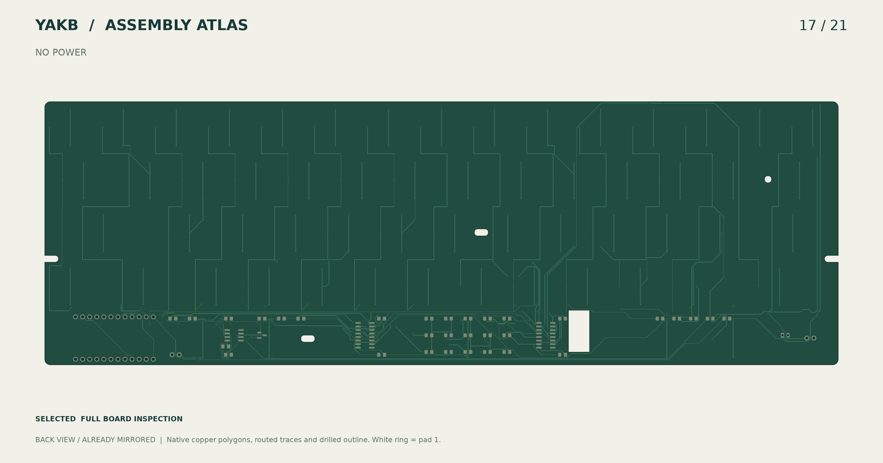
hardware/soldering/b1/step-17.png
