wZuck/YAKB/hardware/soldering/b1/step-18.png

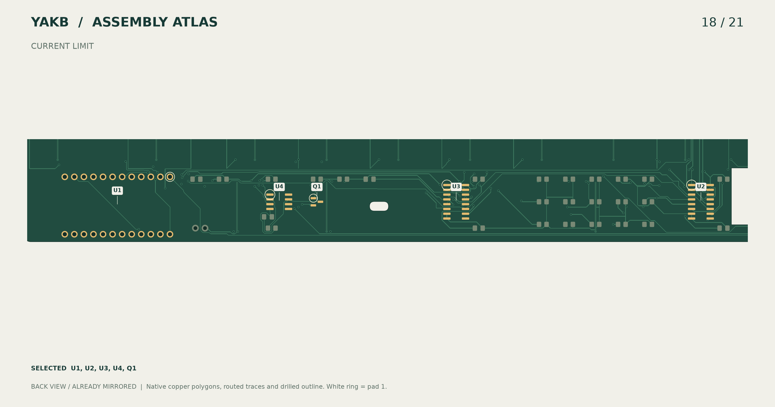
hardware/soldering/b1/step-18.png
