wZuck/YAKB/hardware/soldering/b1/step-19.png

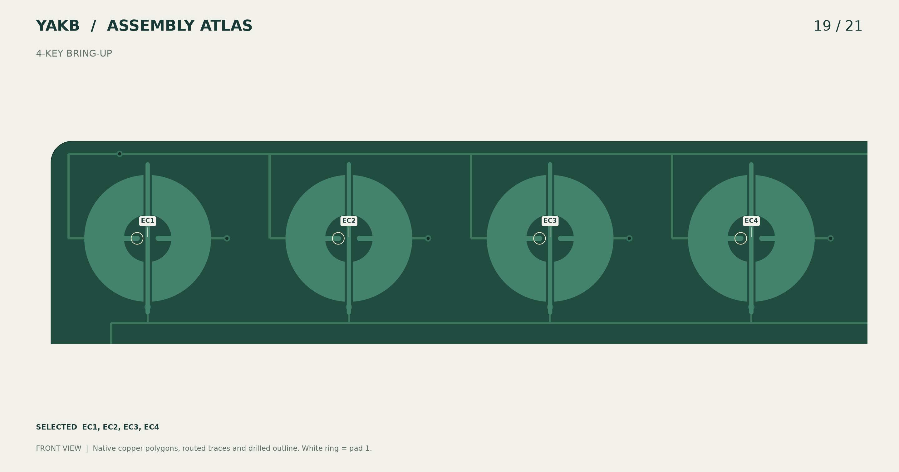
hardware/soldering/b1/step-19.png
