wZuck/YAKB/hardware/soldering/step-05.png

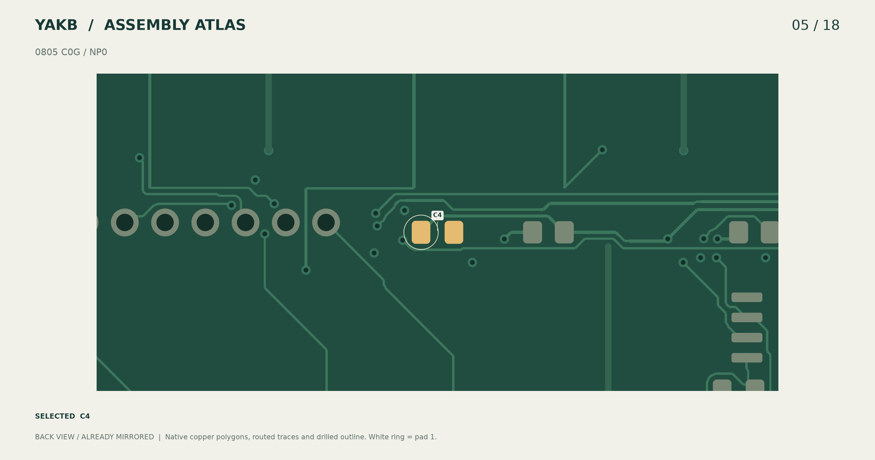
hardware/soldering/step-05.png
