wZuck/YAKB/hardware/soldering/step-13.png

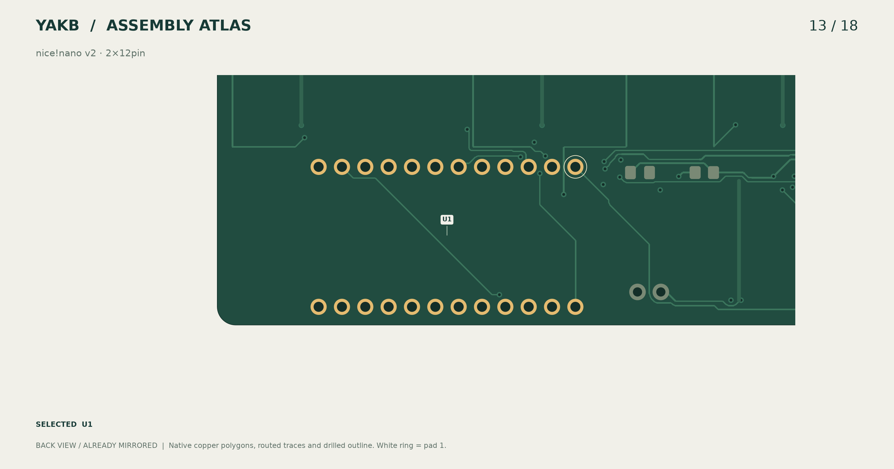
hardware/soldering/step-13.png
