wZuck/YAKB/hardware/YAKB-schematic.pdf

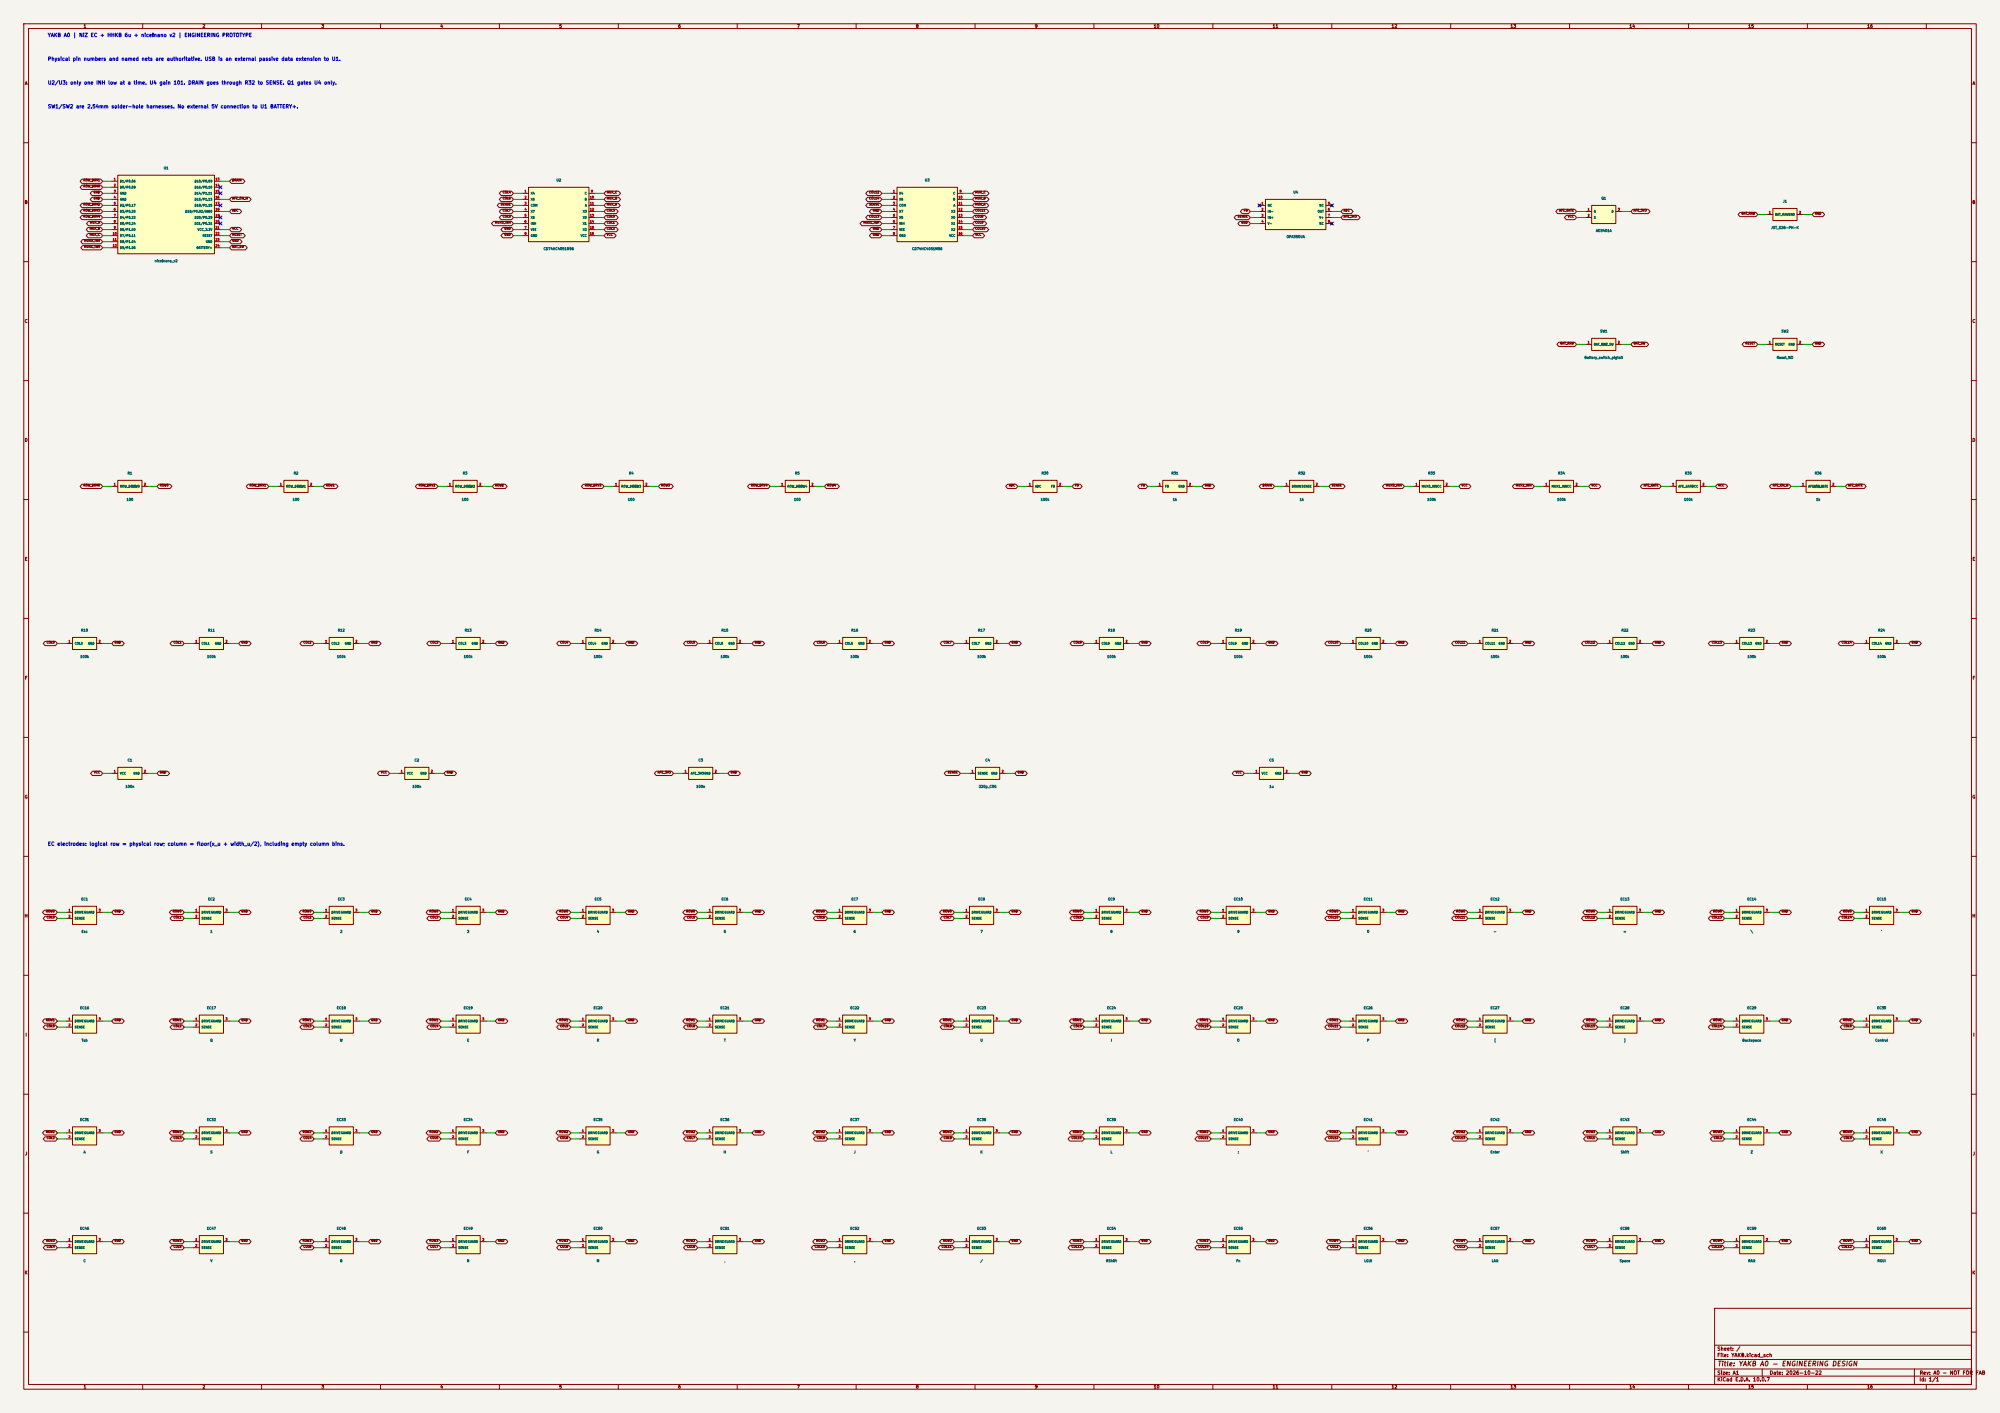
[picture p65: page 1]

YAKB A0 | NiZ EC + HHKB 6u + nice!nano v2 | ENGINEERING PROTOTYPE

Physical pin numbers and named nets are authoritative. USB is an external passive data extension to U1.

U2/U3: only one INH low at a time. U4 gain 101. DRAIN goes through R32 to SENSE. Q1 gates U4 only.

SW1/SW2 are 2.54mm solder-hole harnesses. No external 5V connection to U1 BATTERY+.

EC electrodes: logical row = physical row; column = floor(x_u + width_u/2), including empty column bins.

Sheet: /
File: YAKB.kicad_sch
Title: YAKB A0 - ENGINEERING DESIGN
