wZuck/YAKB/hardware/modular/YAKB-controller-B1.pdf

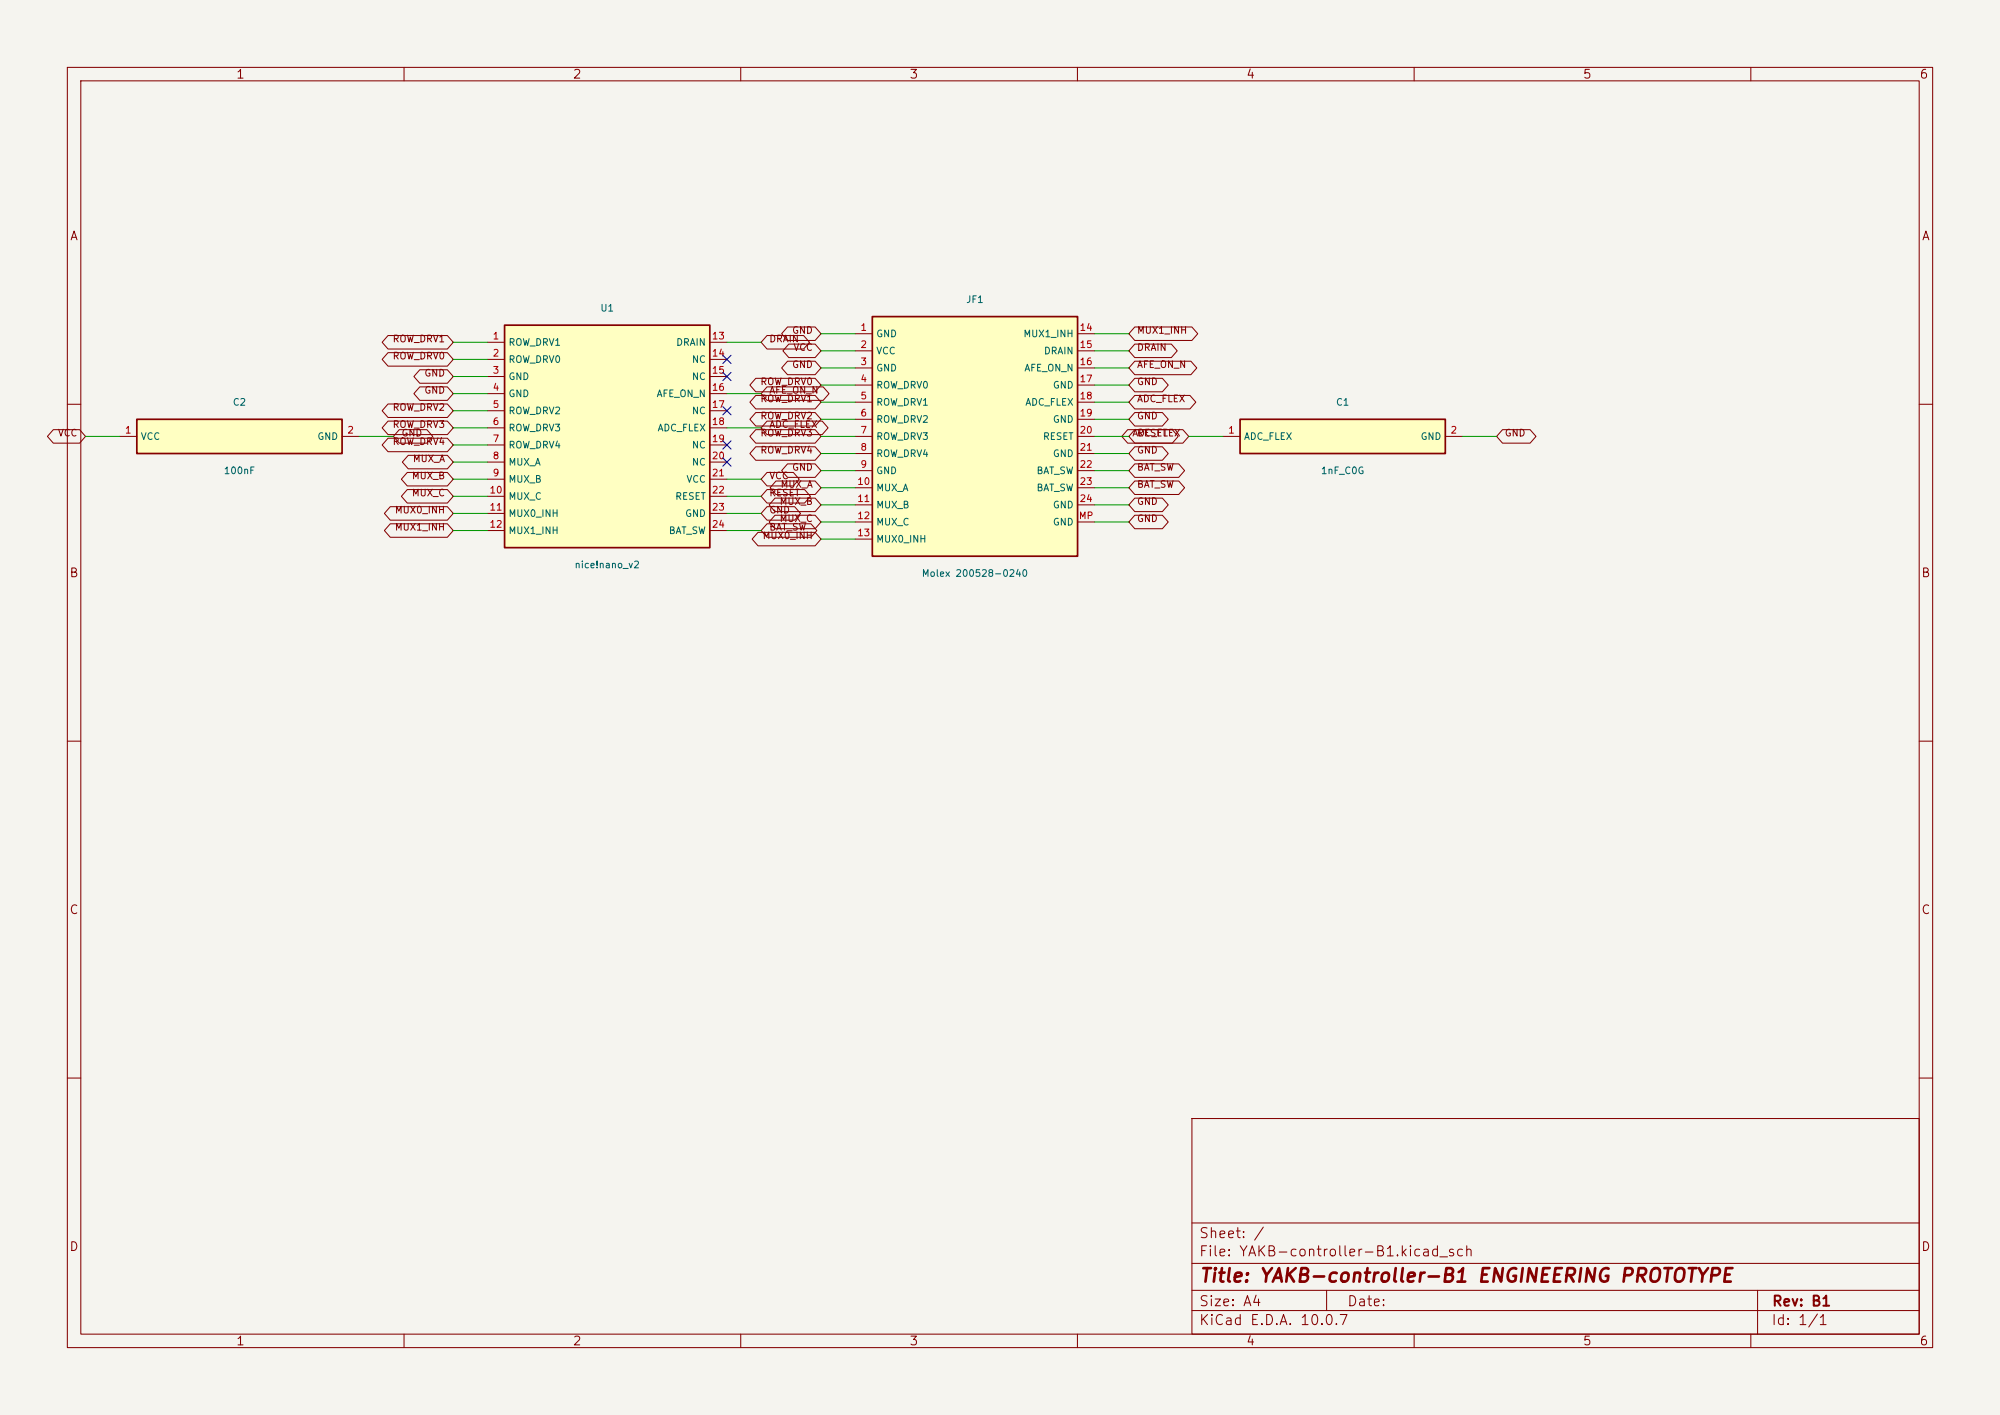
[picture p66: page 1]

Sheet: /
File: YAKB-controller-B1.kicad_sch
Title: YAKB-controller-B1 ENGINEERING PROTOTYPE

Size: A4 | Rev: B1
KiCad E.D.A. 10.0.7 | Id: 1/1
