wZuck/YAKB/hardware/modular/YAKB-FPC-coupon-B1.pdf

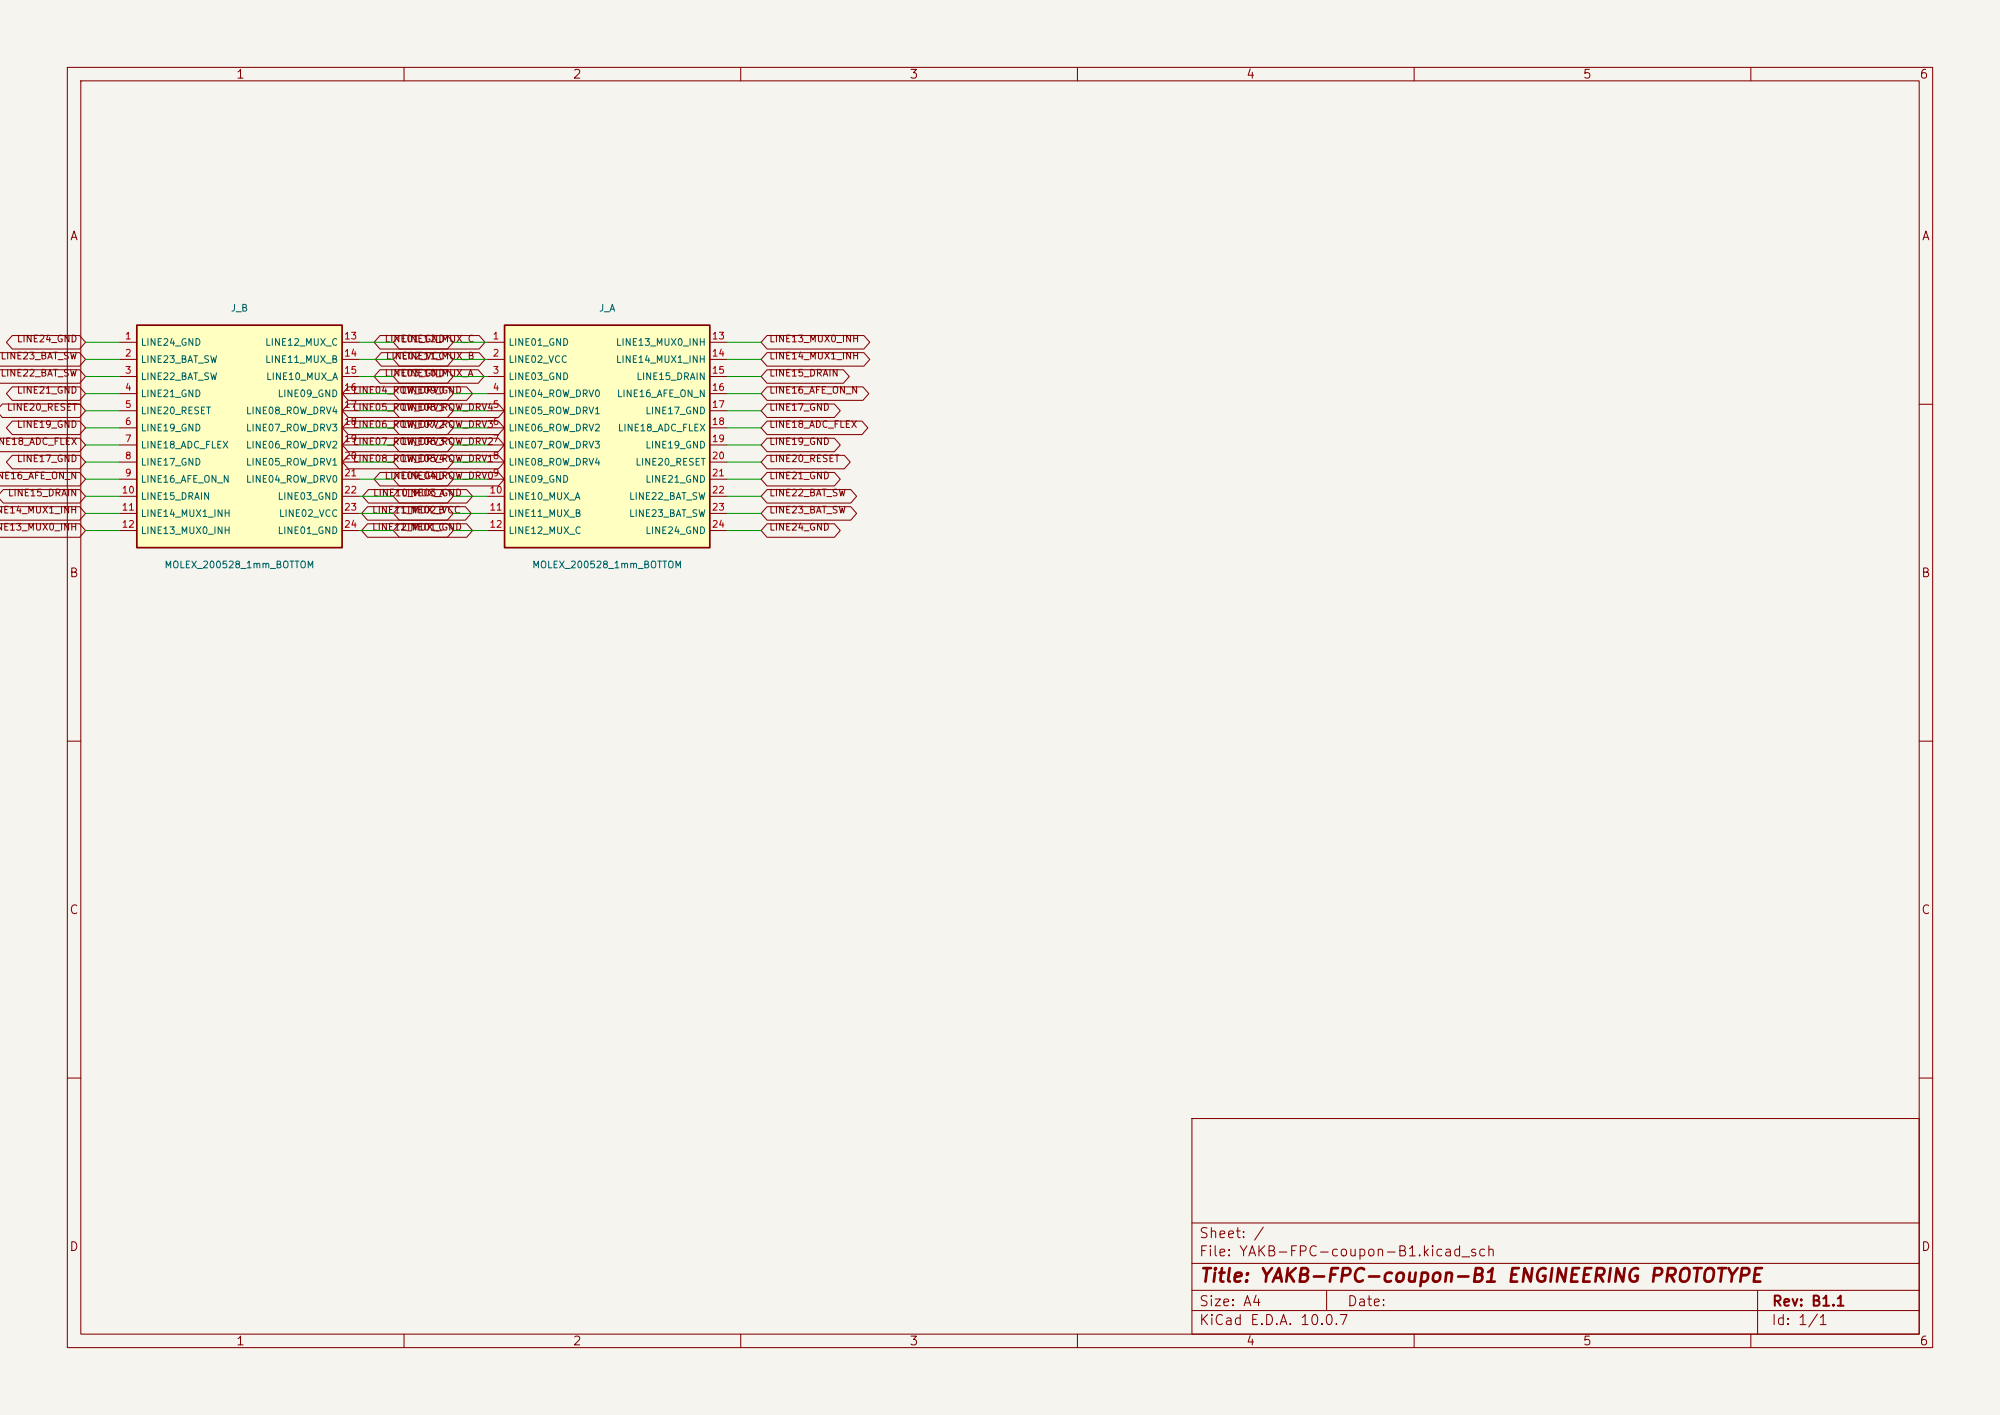
[picture p67: page 1]

Sheet: /
File: YAKB-FPC-coupon-B1.kicad_sch
Title: YAKB-FPC-coupon-B1 ENGINEERING PROTOTYPE

Size: A4 | Rev: B1.1
KiCad E.D.A. 10.0.7 | Id: 1/1
