wZuck/YAKB/hardware/modular/YAKB-interposer-B1.pdf

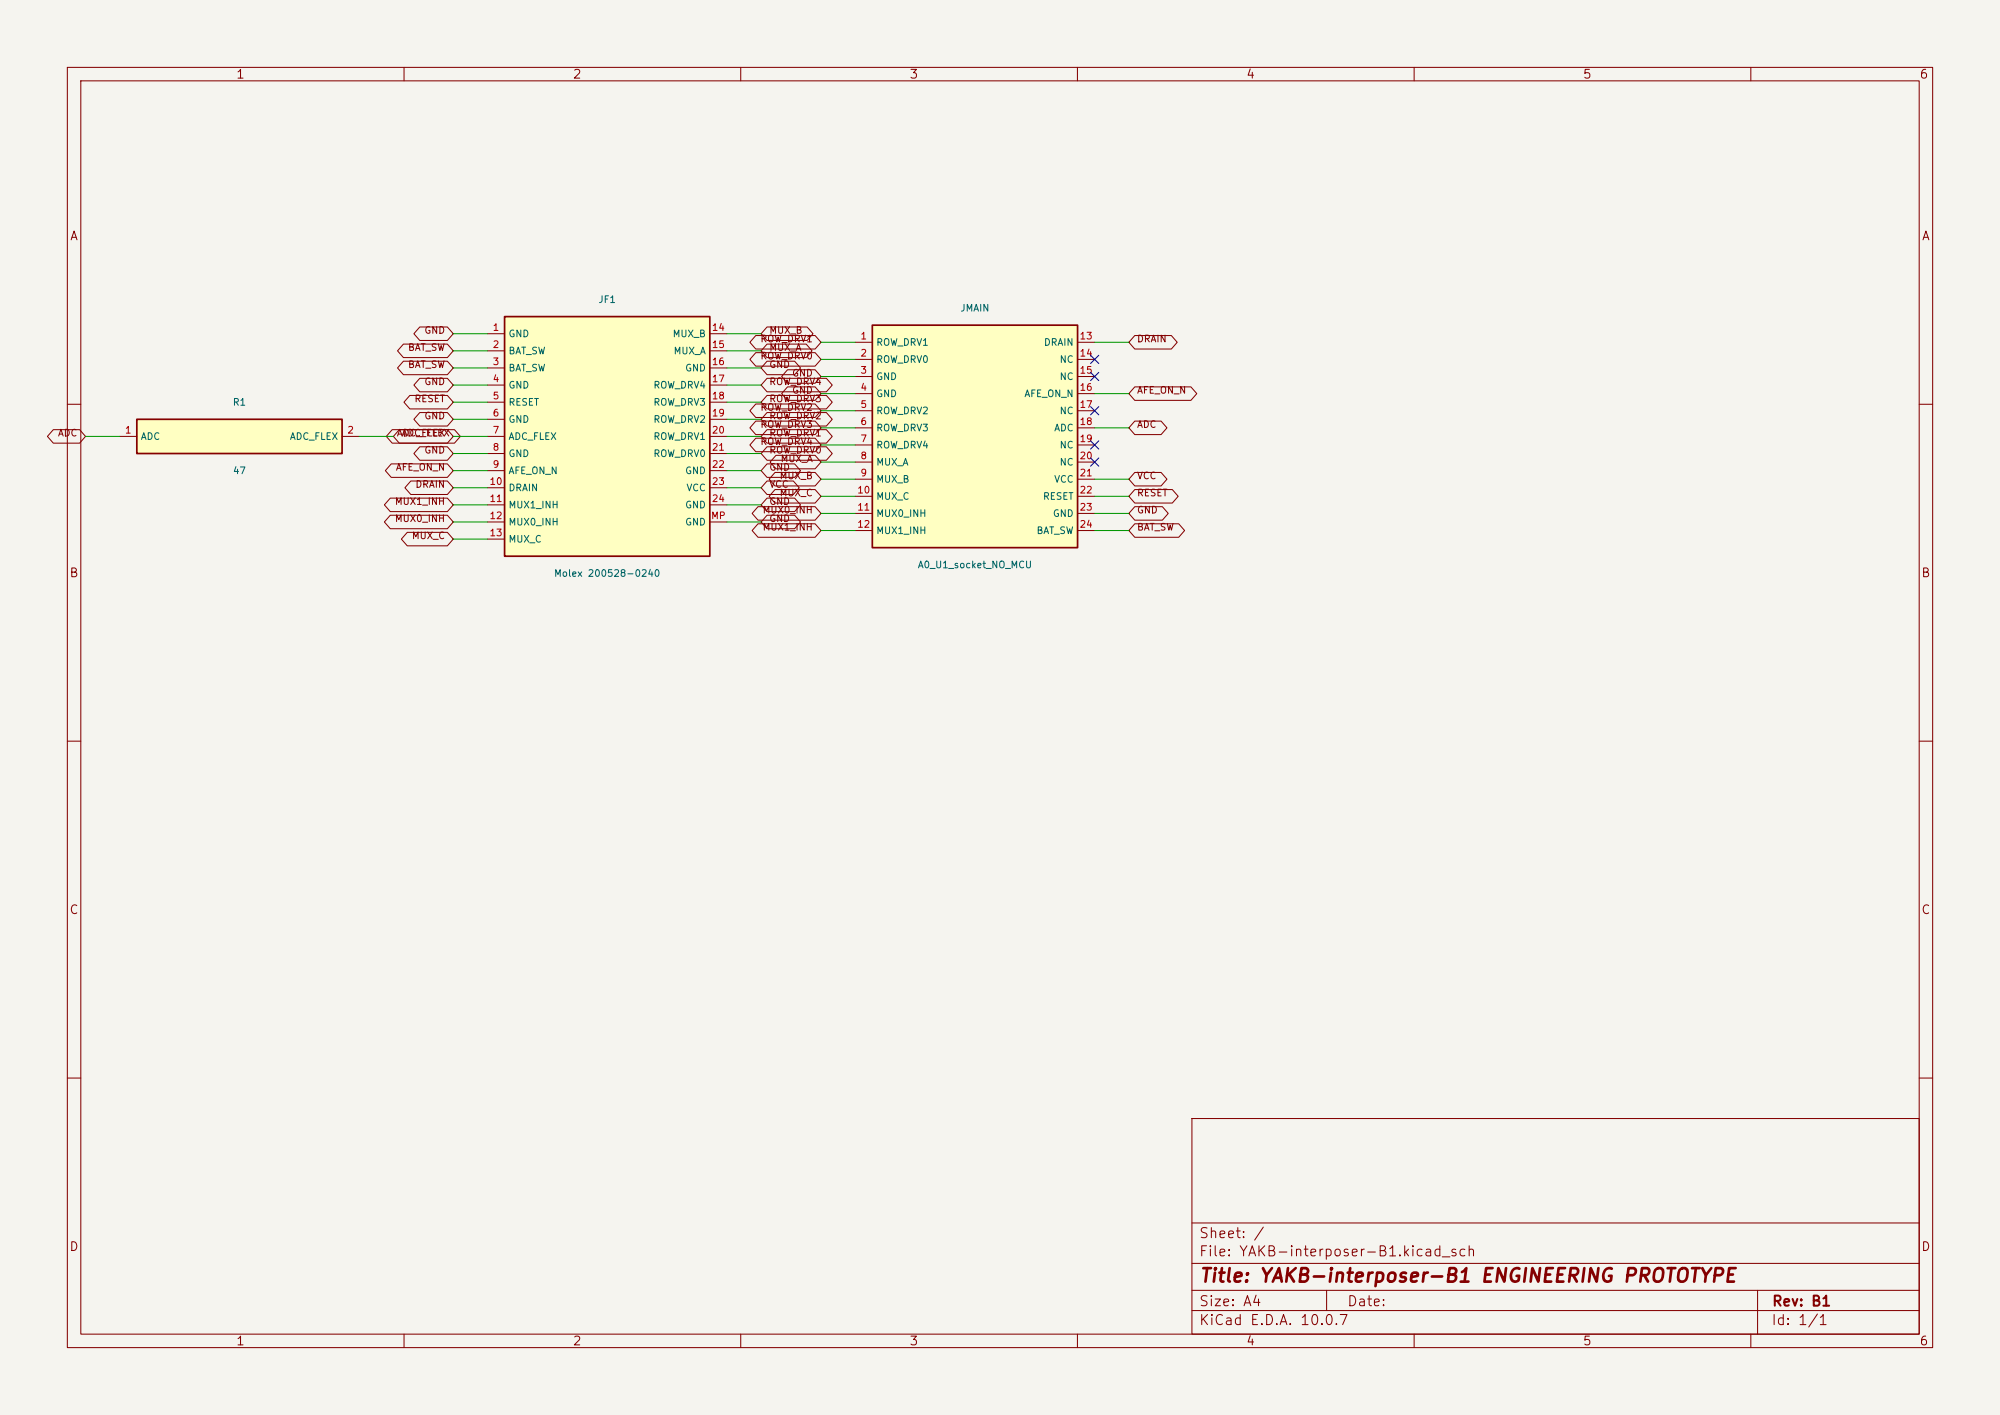
[picture p68: page 1]

Sheet: /
File: YAKB-interposer-B1.kicad_sch
Title: YAKB-interposer-B1 ENGINEERING PROTOTYPE

Size: A4 | Rev: B1
KiCad E.D.A. 10.0.7 | Id: 1/1
