wZuck/YAKB/hardware/modular/YAKB-shaped-FPC-B1.pdf

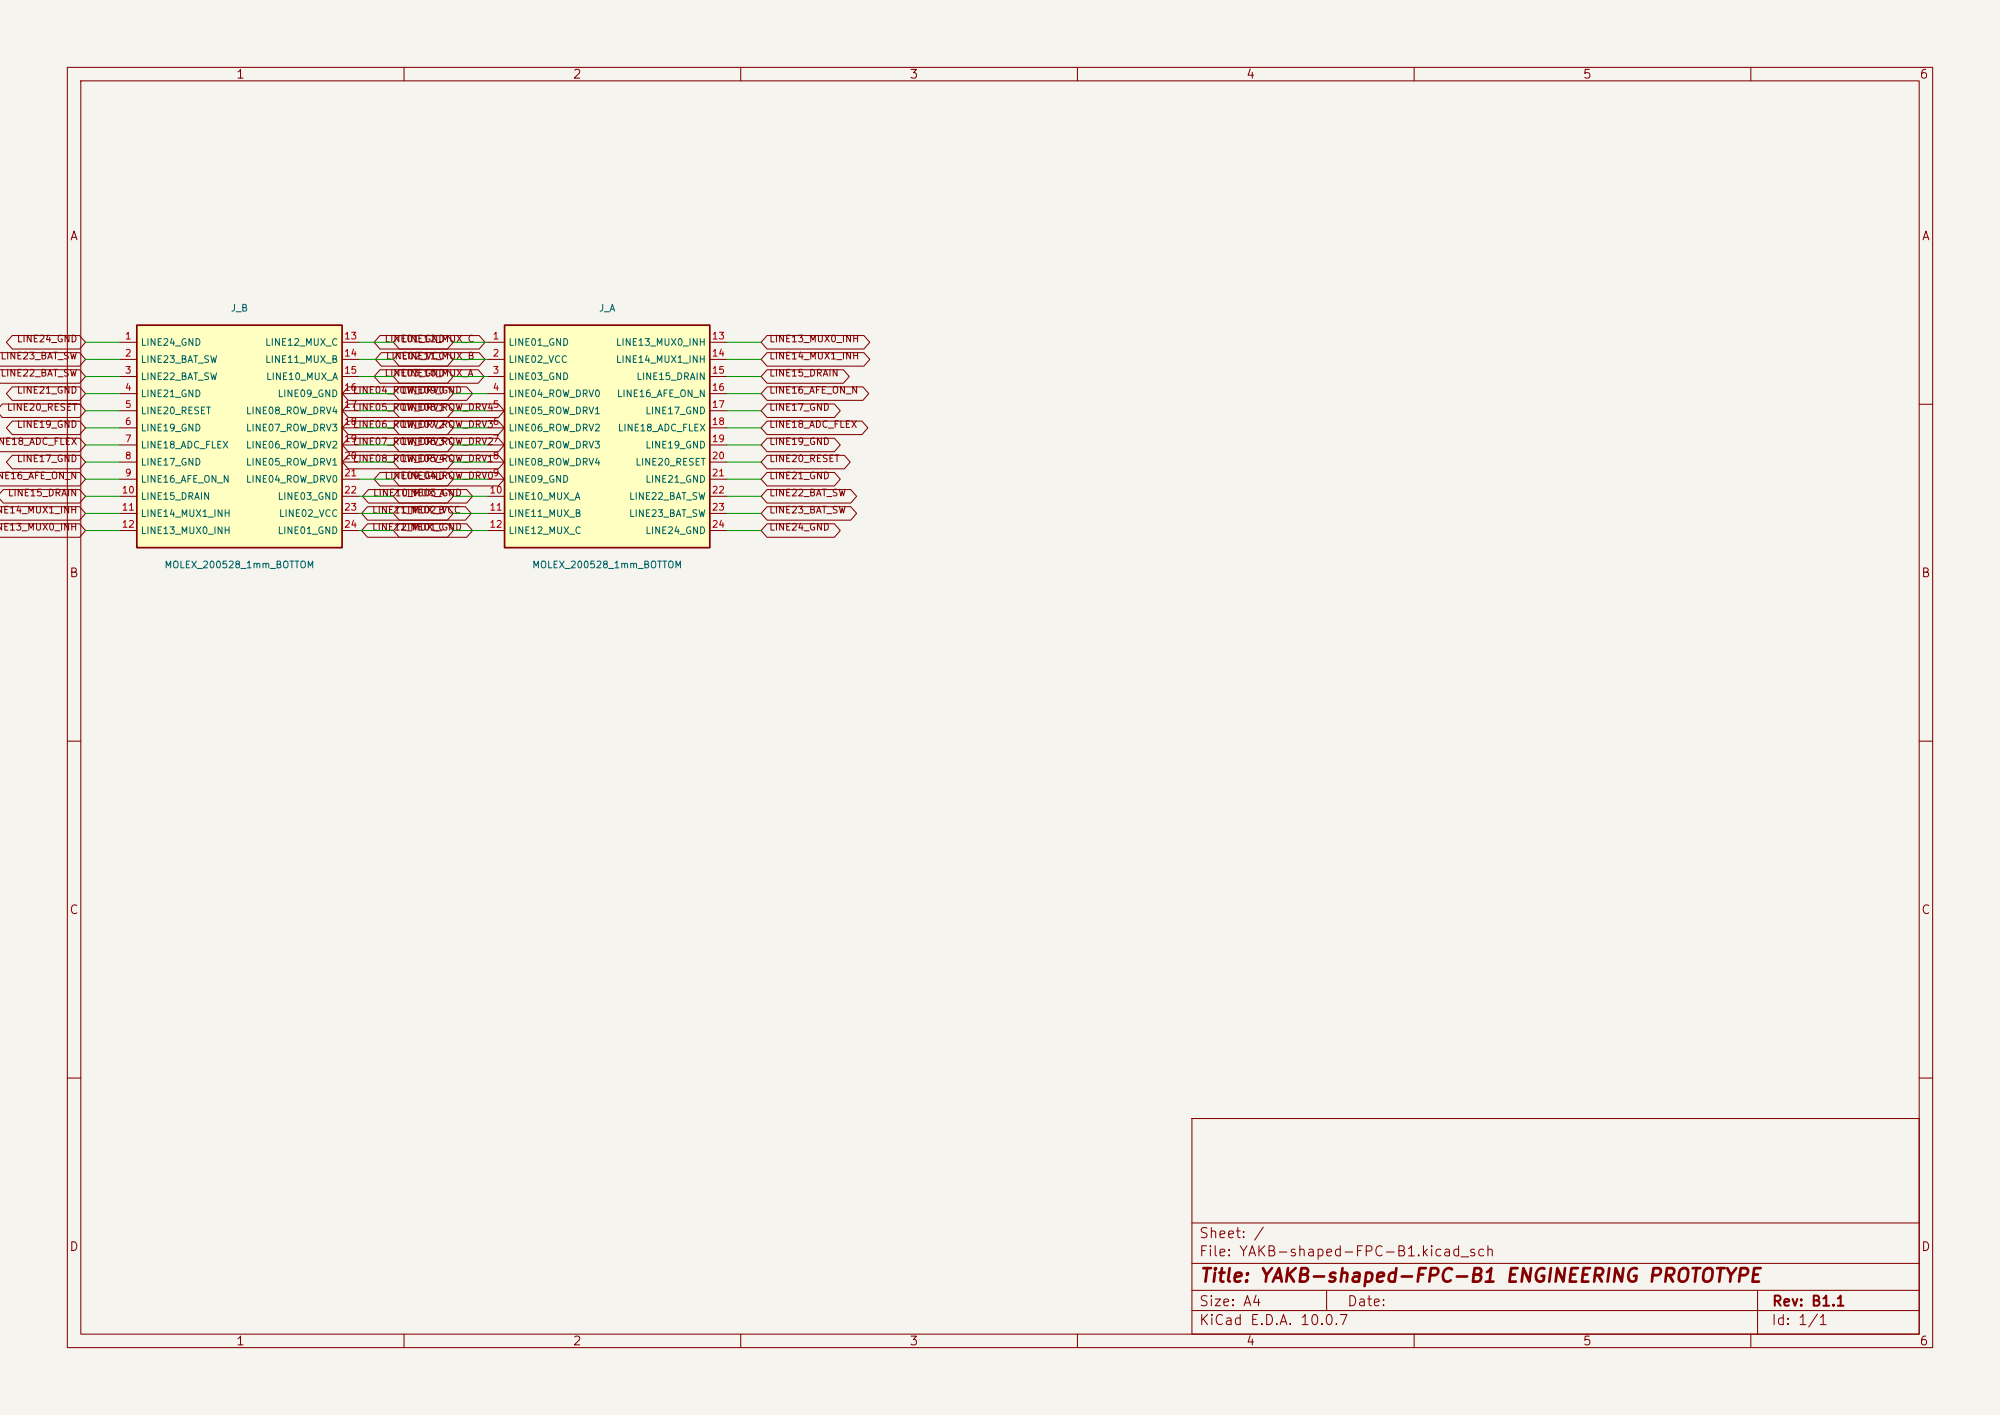
[picture p69: page 1]

Sheet: /
File: YAKB-shaped-FPC-B1.kicad_sch
Title: YAKB-shaped-FPC-B1 ENGINEERING PROTOTYPE

Size: A4 | Rev: B1.1
KiCad E.D.A. 10.0.7 | Id: 1/1
