wZuck/YAKB/(list of files, drawings)

Other design files:
design/pcb-scene.json
reports/pcb-connectivity.json
