wZuck/YAKB/hardware/modular/YAKB-controller-B1.kicad_pcb

## KiCad design hardware/modular/YAKB-controller-B1.kicad_pcb (2026-10-22)

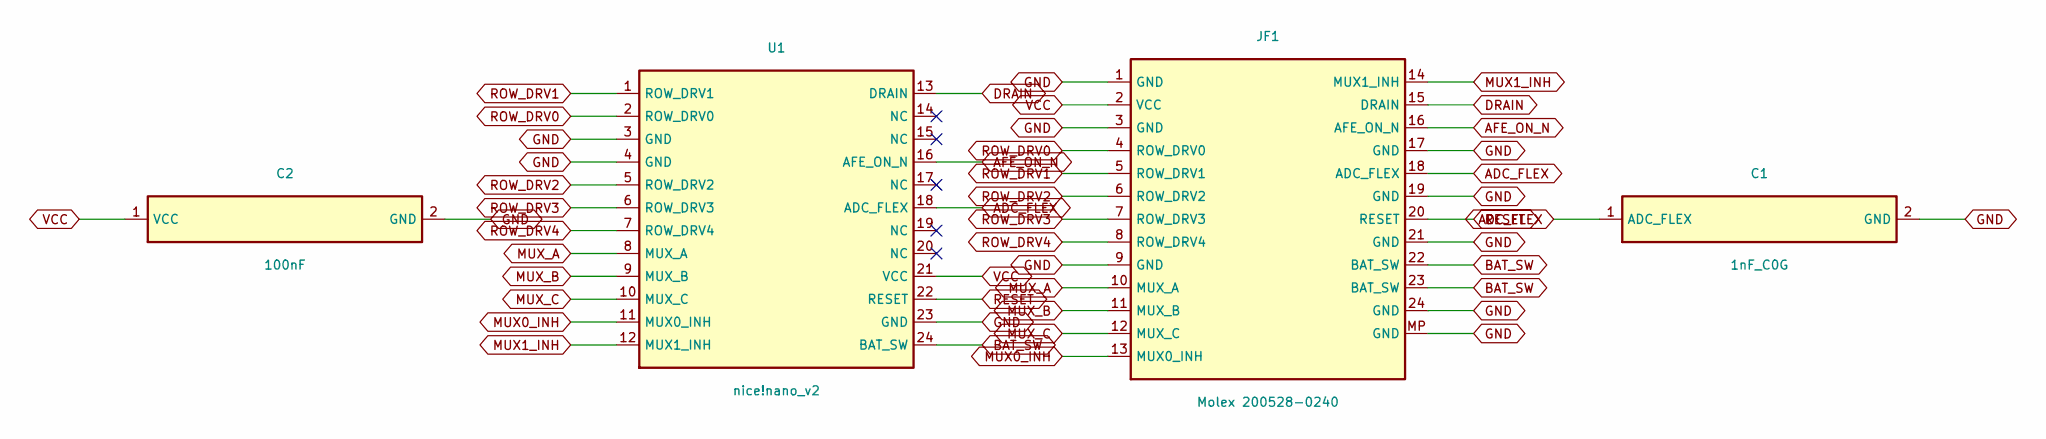
[picture p70: schematic YAKB-controller-B1.kicad_sch, YAKB-controller-B1 ENGINEERING PROTOTYPE]

Parts:
C1: 1nF_C0G; C_0805_2012Metric_Pad1.18x1.45mm_HandSolder
C2: 100nF; C_0805_2012Metric_Pad1.18x1.45mm_HandSolder
JF1: Molex 200528-0240; Molex_200528-0240_1x24-1MP_P1.00mm_Horizontal
U1: nice!nano_v2; nice_nano

Connections:
ADC_FLEX: C1.1 (ADC_FLEX), JF1.18 (ADC_FLEX), U1.18 (ADC_FLEX)
AFE_ON_N: JF1.16 (AFE_ON_N), U1.16 (AFE_ON_N)
BAT_SW: JF1.22 (BAT_SW), JF1.23 (BAT_SW), U1.24 (BAT_SW)
DRAIN: JF1.15 (DRAIN), U1.13 (DRAIN)
GND: C1.2 (GND), C2.2 (GND), JF1.1 (GND), JF1.3 (GND), JF1.9 (GND), JF1.17 (GND), JF1.19 (GND), JF1.21 (GND), JF1.24 (GND), JF1.MP (GND), U1.3 (GND), U1.4 (GND), U1.23 (GND)
MUX0_INH: JF1.13 (MUX0_INH), U1.11 (MUX0_INH)
MUX1_INH: JF1.14 (MUX1_INH), U1.12 (MUX1_INH)
MUX_A: JF1.10 (MUX_A), U1.8 (MUX_A)
MUX_B: JF1.11 (MUX_B), U1.9 (MUX_B)
MUX_C: JF1.12 (MUX_C), U1.10 (MUX_C)
RESET: JF1.20 (RESET), U1.22 (RESET)
ROW_DRV0: JF1.4 (ROW_DRV0), U1.2 (ROW_DRV0)
ROW_DRV1: JF1.5 (ROW_DRV1), U1.1 (ROW_DRV1)
ROW_DRV2: JF1.6 (ROW_DRV2), U1.5 (ROW_DRV2)
ROW_DRV3: JF1.7 (ROW_DRV3), U1.6 (ROW_DRV3)
ROW_DRV4: JF1.8 (ROW_DRV4), U1.7 (ROW_DRV4)
VCC: C2.1 (VCC), JF1.2 (VCC), U1.21 (VCC)

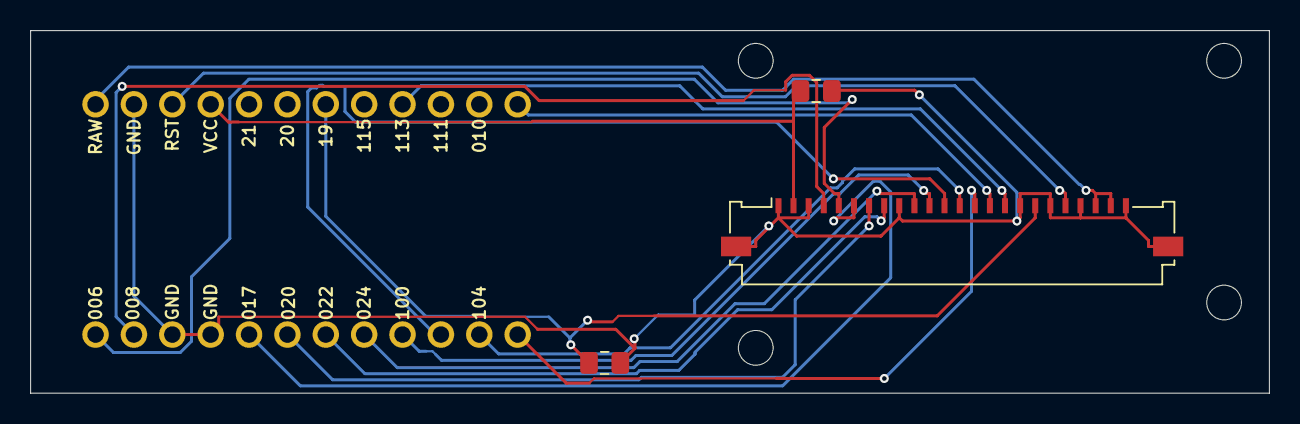
[picture p71: board YAKB-controller-B1.kicad_pcb from above]

Board: 2 copper layers, 82.0 x 24.0 mm, 8 parts (0 on the bottom side), 17 nets.

Other parts of the board:
H1, H2, H3, H4: (no value)
