wZuck/YAKB/hardware/modular/YAKB-interposer-B1.kicad_pcb

## KiCad design hardware/modular/YAKB-interposer-B1.kicad_pcb (2026-10-22)

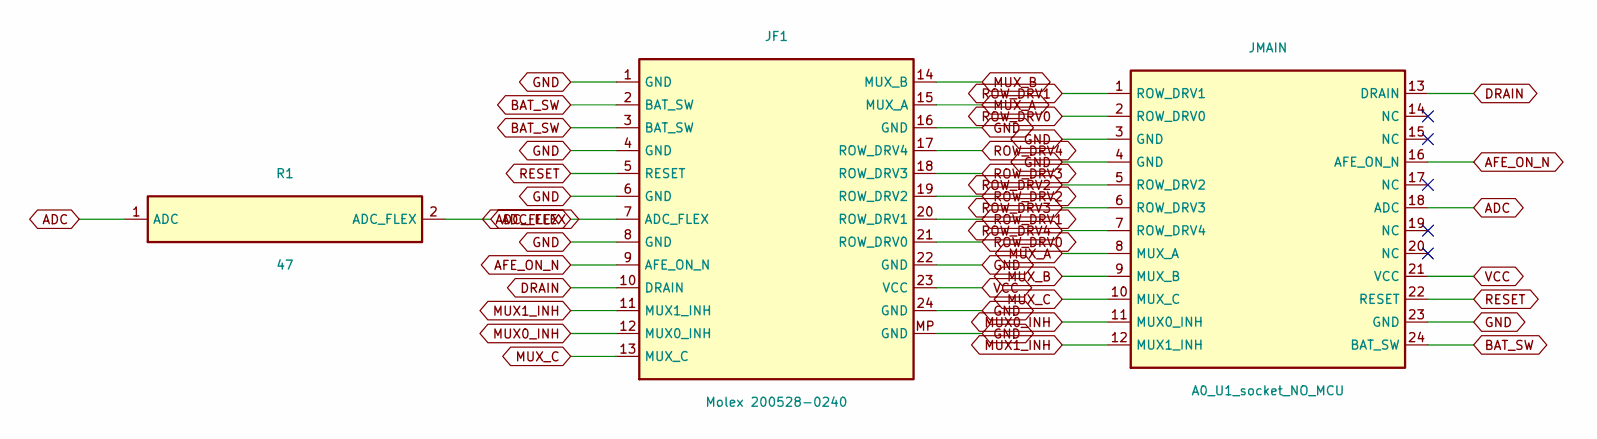
[picture p72: schematic YAKB-interposer-B1.kicad_sch, YAKB-interposer-B1 ENGINEERING PROTOTYPE]

Parts:
JF1: Molex 200528-0240; Molex_200528-0240_1x24-1MP_P1.00mm_Horizontal
JMAIN: A0_U1_socket_NO_MCU; A0_U1_socket_adapter
R1: 47; R_0805_2012Metric_Pad1.20x1.40mm_HandSolder

Connections:
ADC: JMAIN.18 (ADC), R1.1 (ADC)
ADC_FLEX: JF1.7 (ADC_FLEX), R1.2 (ADC_FLEX)
AFE_ON_N: JF1.9 (AFE_ON_N), JMAIN.16 (AFE_ON_N)
BAT_SW: JF1.2 (BAT_SW), JF1.3 (BAT_SW), JMAIN.24 (BAT_SW)
DRAIN: JF1.10 (DRAIN), JMAIN.13 (DRAIN)
GND: JF1.1 (GND), JF1.4 (GND), JF1.6 (GND), JF1.8 (GND), JF1.16 (GND), JF1.22 (GND), JF1.24 (GND), JF1.MP (GND), JMAIN.3 (GND), JMAIN.4 (GND), JMAIN.23 (GND)
MUX0_INH: JF1.12 (MUX0_INH), JMAIN.11 (MUX0_INH)
MUX1_INH: JF1.11 (MUX1_INH), JMAIN.12 (MUX1_INH)
MUX_A: JF1.15 (MUX_A), JMAIN.8 (MUX_A)
MUX_B: JF1.14 (MUX_B), JMAIN.9 (MUX_B)
MUX_C: JF1.13 (MUX_C), JMAIN.10 (MUX_C)
RESET: JF1.5 (RESET), JMAIN.22 (RESET)
ROW_DRV0: JF1.21 (ROW_DRV0), JMAIN.2 (ROW_DRV0)
ROW_DRV1: JF1.20 (ROW_DRV1), JMAIN.1 (ROW_DRV1)
ROW_DRV2: JF1.19 (ROW_DRV2), JMAIN.5 (ROW_DRV2)
ROW_DRV3: JF1.18 (ROW_DRV3), JMAIN.6 (ROW_DRV3)
ROW_DRV4: JF1.17 (ROW_DRV4), JMAIN.7 (ROW_DRV4)
VCC: JF1.23 (VCC), JMAIN.21 (VCC)

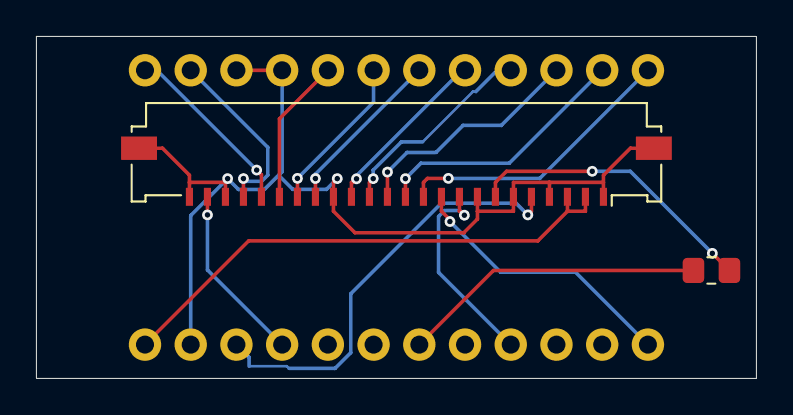
[picture p73: board YAKB-interposer-B1.kicad_pcb from above]

Board: 2 copper layers, 40.0 x 19.0 mm, 3 parts (0 on the bottom side), 18 nets.
