wZuck/YAKB/(commit log)

2026-10-22 feat: add YAKB NiZ HHKB wireless keyboard design
    [BOM.csv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]
2026-10-22 fix: validate YAKB hardware, hide fasteners and add battery options
    [BOM.csv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]
2026-10-22 fix: separate EC and battery ADC channels and reconcile inventory BOM
    [BOM.csv]
2026-10-22 fix: unify CAD handedness and document incomplete USB assembly
    [assembly.step, battery_envelope.step, battery_pack_envelopes.step, case_base.step, case_base.stl, case_base_three_bay.step, case_base_three_bay.stl, case_bezel.step]
2026-10-22 feat(hardware): move controller to modular rear USB carrier
    [BOM-B1.csv, FPC-pinout.csv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]
2026-10-23 fix(hardware): correct FPC mating geometry and add fit coupons
    [BOM-B1.csv, YAKB-FPC-coupon-B1-native.step, YAKB-FPC-coupon-B1.kicad_pcb, YAKB-FPC-coupon-B1.kicad_sch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]
2026-10-23 fix: reconcile B1 documentation BOM and power estimates
    [BOM-B1-complete.csv, YAKB-FPC-coupon-B1-netlist.csv, YAKB-controller-B1-netlist.csv, YAKB-interposer-B1-netlist.csv, YAKB-shaped-FPC-B1-netlist.csv, placement-checklist.csv]
